bhardwajRahul/autonomous-computer/README.md

# Time to build your own Personal AI Computer

https://github.com/user-attachments/assets/36f7aa02-42ac-4b35-b757-a5dd3b43ef1a

## The future of AI is local

AI in 2026 looks like computing in 1975: the intelligence lives in a few mainframes, owned by a few companies, and you rent it by the token. Everyone knows how that movie ends. The machine moves onto the desk — and the people who own their machines build everything that comes next.

The Personal AI Computer is that machine. The models are good, the GPUs are affordable, and homes and businesses are reaching the same answer: bring it in-house. Three reasons:

1. **No one can switch you off.** In June 2026 the US government took Fable 5 offline for most of a month and gated GPT-5.6 behind an approved-partner list. Weights on your own disk can't be revoked.
2. **Your business is their training data.** Every prompt you send OpenAI or Anthropic carries your product, your process, your edge. They will turn your secret sauce into their product.
3. **Inference becomes free.** Open weights on a cloud API already cut the bill 20–30×. On your own machine there is no bill at all. No API, no meter.

## The end-to-end open-source local AI stack

Open software lets you run and shape your AI; open hardware lets you build, repair, and improve the machine it runs on. With both in your hands — the code, the CAD, the BOM, the BIOS settings — you can build the whole thing end to end. So we open-source both:

- **Open Source Hardware — this repo.** Your Personal AI Computer in four sizes, below: every part, every bracket, every BIOS setting, every assembly photo.
- **Open Source Software — your choice.** The easiest way is [Grid](https://github.com/autonomous-ai/autonomous-grid), the open orchestrator for local AI — but any local AI engine works: vLLM, Ollama, llama.cpp.

## 2× NVIDIA RTX 5090

The entry-level build, for personal use. Enough for Llama, Qwen, and DeepSeek with quantization — run OpenClaw, Hermes Agent, or your own LangChain stack locally.

- **2× NVIDIA RTX 5090** — 64 GB VRAM · 3,584 GB/s · 419 FP32 TFLOPS
- **Intel Xeon W5** (ASUS W790 ACE) · 96 GB RAM · 1 TB NVMe
- **PCIe Gen 5 ×16** per GPU · 10 GbE + 2.5 GbE
- **1,550 W draw** · 1,600 W PSU
- **12.5″ × 12.5″ × 16″** · 33 lb

**[Build the 2× 5090 →](2x-5090/README.md)**

<a href="2x-5090/README.md">The 2× 5090 build — two RTX 5090s on the open frame</a>

<table>
<tr>
<td width="50%">Seating the PCIe riser</td>
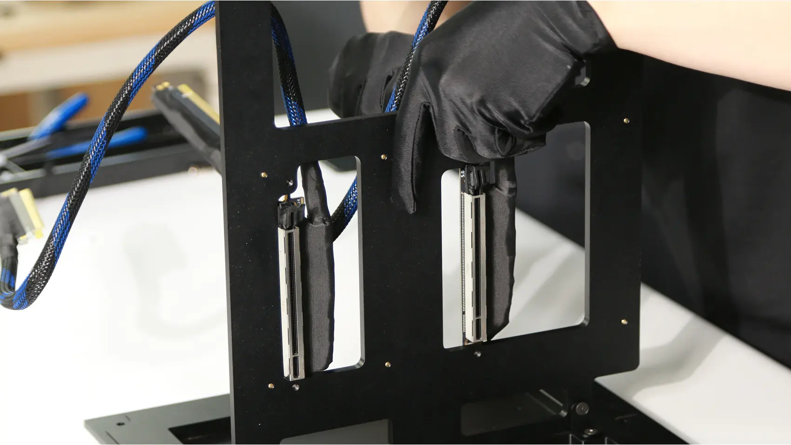
[picture p1: 2x/photos/gallery/riser-frame.webp]
Mounting the PCIe 5.0 risers
<td width="50%"></td>
</tr>
<tr>
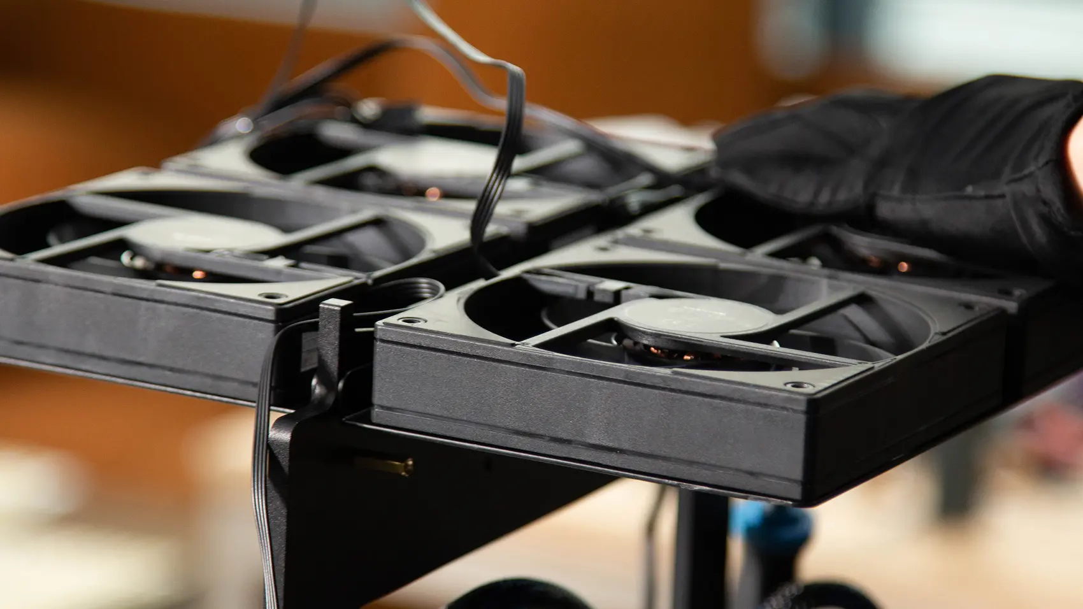
[picture p2: 2x/photos/gallery/fan-tray.webp]
The fan tray
<td width="50%"></td>
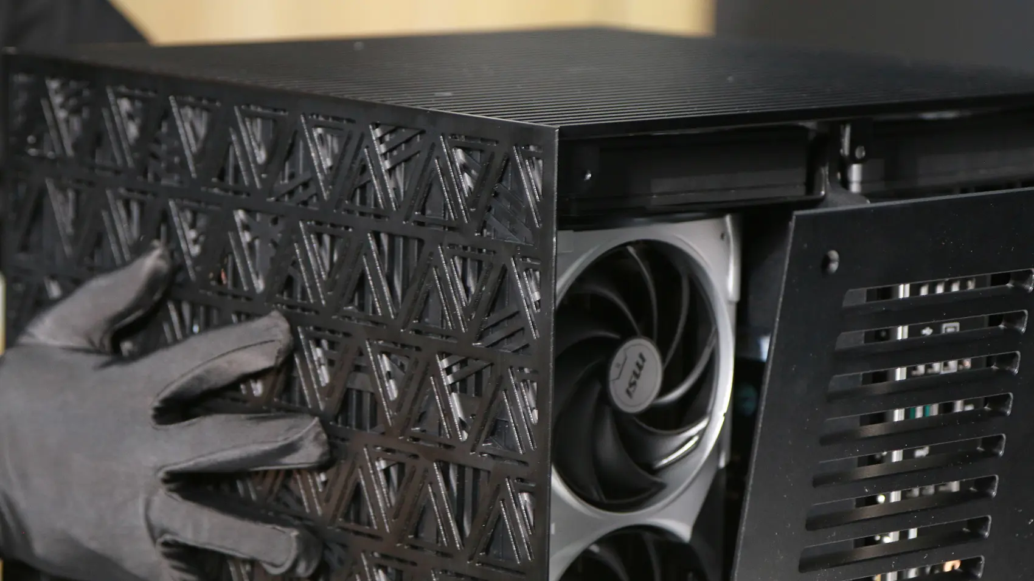
[picture p3: 2x/photos/gallery/side-panel.webp]
Closing the side panel
<td width="50%"></td>
</tr>
</table>

The finished 2× 5090

## 4× NVIDIA RTX 5090

The team build. Larger open models like Kimi, MiniMax, and GLM. No API bills. Low latency. Private data.

- **4× NVIDIA RTX 5090** — 128 GB VRAM · 7,168 GB/s · 838 FP32 TFLOPS
- **AMD Ryzen Threadripper Pro** · 96 GB RAM · 1 TB NVMe
- **PCIe Gen 5 ×16** per GPU · 2× 10 GbE · BMC
- **2,750 W draw** · 4,000 W PSU
- **12.5″ × 12.5″ × 16″** · 66 lb

**[Build the 4× 5090 →](4x-5090/README.md)**

<a href="4x-5090/README.md">The 4× 5090 build — four RTX 5090s in the cube housing</a>

<table>
<tr>
<td width="50%">Motherboard on the fan chassis</td>
<td width="50%">Cabling the power supplies</td>
</tr>
<tr>
<td width="50%">Mounting a GPU to the frame</td>
<td width="50%">All four RTX 5090s on the frame</td>
</tr>
</table>

The finished 4× 5090

## 8× NVIDIA RTX 5090

The on-prem build, for business. Develop, serve, and fine-tune with open models — the work that should never leave your floor.

- **8× NVIDIA RTX 5090** — 256 GB VRAM · 14,336 GB/s · 1,676 FP32 TFLOPS
- **2× AMD EPYC 9004** (ASRock Rack GENOA2D24G-2L+) · 192 GB RAM · 1 TB NVMe
- **PCIe Gen 5 ×16** per GPU, over MCIO · 2× 1 GbE · BMC
- **5,100 W draw** · 8,000 W PSU
- **15.5″ × 15.5″ × 24″** · 110 lb · CNC-milled anodized aluminum housing

**[Build the 8× 5090 →](8x-5090/README.md)**

<a href="8x-5090/README.md">The 8× 5090 build — eight GPUs in the anodized aluminum housing</a>

<table>
<tr>
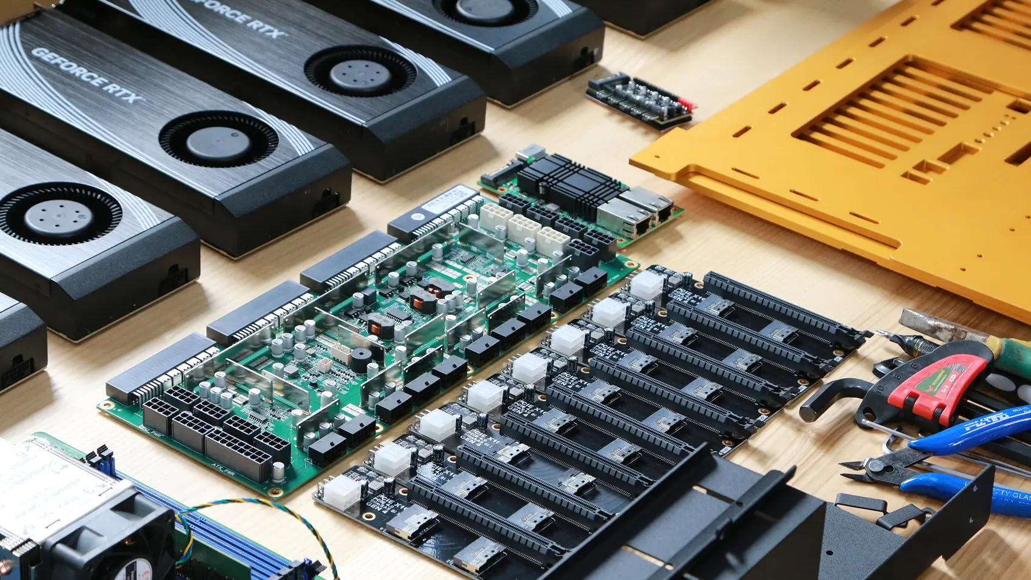
[picture p4: 8x/photos/gallery/parts-layout.webp]
Every part laid out before assembly
<td width="50%"></td>
<td width="50%">Placing an MCIO adapter</td>
</tr>
<tr>
<td width="50%">Cabling the PCIe adapters</td>
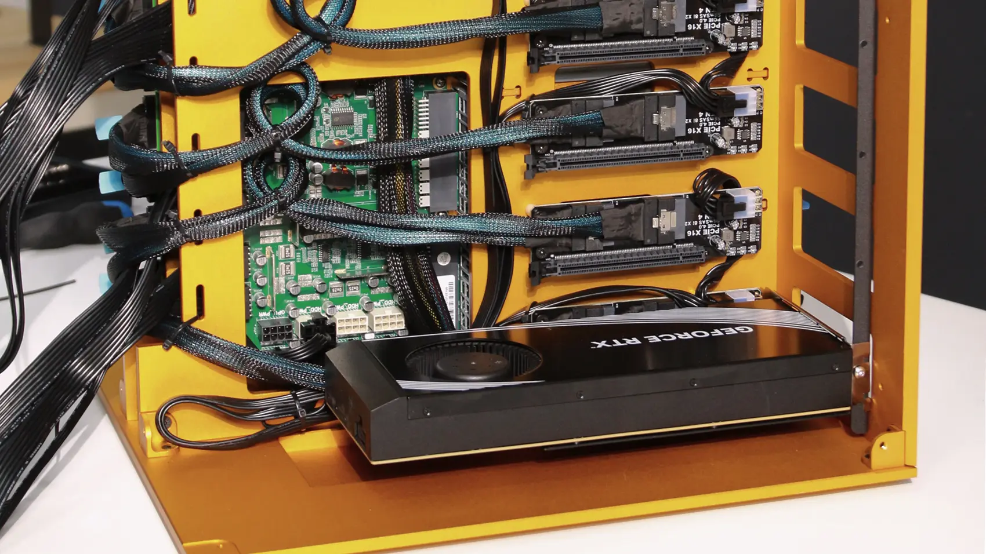
[picture p5: 8x/photos/gallery/gpu-install.webp]
Installing the GPUs
<td width="50%"></td>
</tr>
</table>

The finished 8× 5090

## 4× NVIDIA RTX PRO 6000

The server build — rack-ready for on-prem and the data center. 384 GB of VRAM: fine-tune and serve the biggest open models.

- **4× NVIDIA RTX PRO 6000 Blackwell** — 384 GB GDDR7 ECC · 7,168 GB/s (96 GB per card)
- **AMD EPYC 9124** (ASRock Rack TURIN2D24G-2L+) · 384 GB DDR5 ECC · 1 TB NVMe
- **PCIe Gen 5 ×16** per GPU, over MCIO · BMC
- **3× 2,000 W** CRPS
- **5U rack chassis**

**[Build the 4× 6000 →](4x-6000/README.md)**

<a href="4x-6000/README.md">The 4× 6000 build racked — 5U chassis in the server rack</a>

<table>
<tr>
<td width="50%">Installing the RTX PRO 6000s</td>
<td width="50%">Four flow-through RTX PRO 6000s over the airflow modules</td>
</tr>
<tr>
<td width="50%">Full chassis interior — GPUs, fan wall, dual-SP5 board</td>
<td width="50%">MCIO riser boards before the GPUs go in</td>
</tr>
</table>

GPU power cabling detail

## Software

1. **[BIOS tuning and GPU testing](setup.md)** — after you build the rig, run this to make sure it actually works: BIOS settings for multi-GPU, NVIDIA drivers, then confirm every GPU is detected, linked at full PCIe width, and stable under load.

gpu-testing

2. **Serve your models** — the rig runs, now put it to work. The easiest way is [Grid](https://github.com/autonomous-ai/autonomous-grid), the open orchestrator for local AI: it pools your machines into one local AI network. Or run any local AI engine — vLLM, Ollama, llama.cpp.

   ```bash
   curl -fsSL https://grid.autonomous.ai/install.sh | bash
   ```

home-grid (1)

## Contributing

Built one? Improved a part? Found a better component? See [**CONTRIBUTING.md**](CONTRIBUTING.md) — and [share your build](https://github.com/autonomous-ai/autonomous-computer/issues/new?template=share-your-build.md). The best community builds get featured.

## License

Open source under the [MIT License](LICENSE). Fork it, change it, build your own and sell it — we just want it built.

---

<div align="center">
<b>Autonomous</b> — the AI hardware company.<br>
Questions? <a href="https://github.com/autonomous-ai/autonomous-computer/issues">Open an issue.</a>
</div>
