bhardwajRahul/autonomous-computer/Docs/Prepare_EE.md

<table>
    <tr>
        <td valign="top" align="center" width="50%">
            <b>1. Motherboard GENOA2D24G-2L+</b><br>
            <br>
            <b>3. CPU AMD EPYC 9004</b><br>
            <br>
            <b>5. SSD NVME 1TB</b><br>
            <br>
            <b>7. RAM DDR5 48GB</b><br>
            <br>
            <b>9. MCIO Adapter</b><br>
            <br>
            <b>11. MCIO cable</b><br>
            <br>
            <b>13. Fan</b><br>
            <br>
            <b>15. Motherboard power cable</b><br>
            <br>
        </td>
        <td valign="top" align="center" width="50%">
            <b>2. PSU board</b><br>
            <br>
            <b>4. CPU heat sink</b><br>
            <br>
            <b>6. SSD heat sink</b><br>
            <br>
            <b>8. PSU</b><br>
            <br>
            <b>10. Power cord</b><br>
            <br>
            <b>12. GPU</b><br>
            <br>
            <b>14. Hub fan</b><br>
            <br>
            <b>16. GPU power cable</b><br>
            <br>
        </td>
    </tr>
</table>

---
