bhardwajRahul/autonomous-computer/4x-5090/docs/prepare-ee.md

# Preparation — Electronic & Electrical

Every part in the [bill of materials](../bom/bom.md), photographed. Lay them all out before you start assembly.

> **Mostly representative product images — pending photos of the actual build** (the GPUs, item 6, are from this build). Exact models are being confirmed; see the BOM for the parts marked TBD.

<table>
    <tr>
        <td valign="top" align="center" width="50%">
            <b>1. Mainboard — AMD WRX90 (model TBD)</b><br>
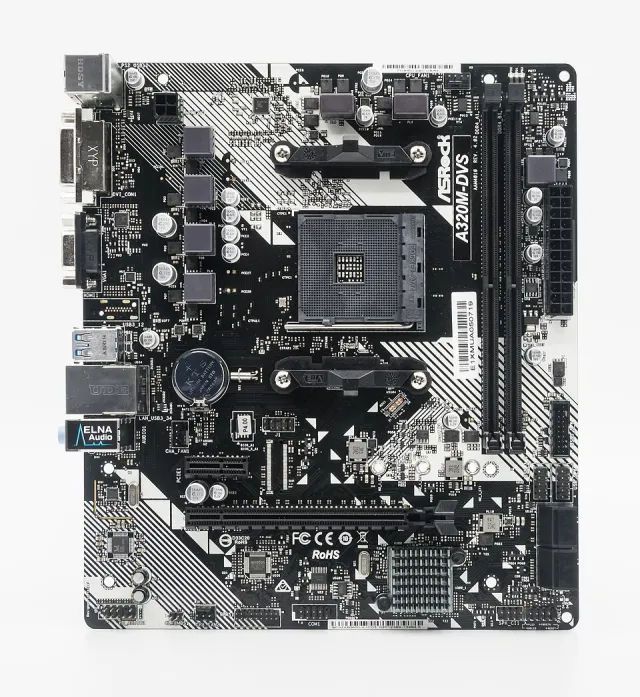
[picture p18: 4x-5090/photos/4gpu/preparing/ee/motherboard.webp]
            <br>
            <b>3. CPU heatsink — sTR5 cooler</b><br>
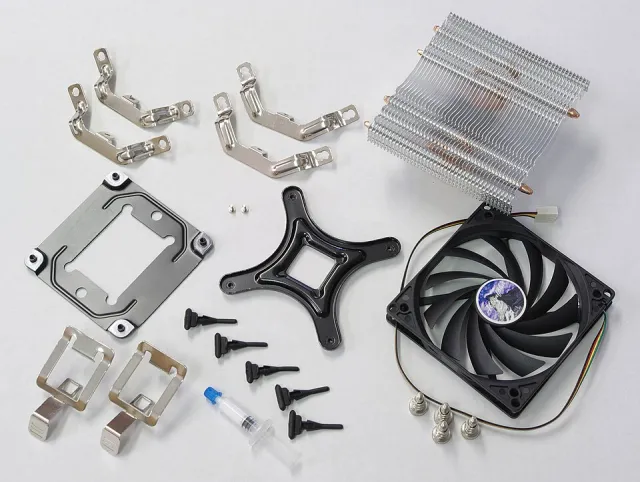
[picture p19: 4x-5090/photos/4gpu/preparing/ee/cpu-heatsink.webp]
            <br>
            <b>5. SSD — 1 TB NVMe</b><br>
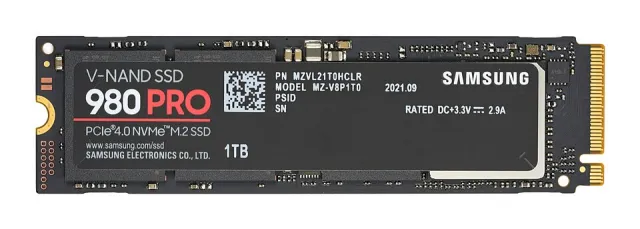
[picture p20: 4x-5090/photos/4gpu/preparing/ee/ssd.webp]
            <br>
            <b>7. PCIe 5.0 riser cable (×4)</b><br>
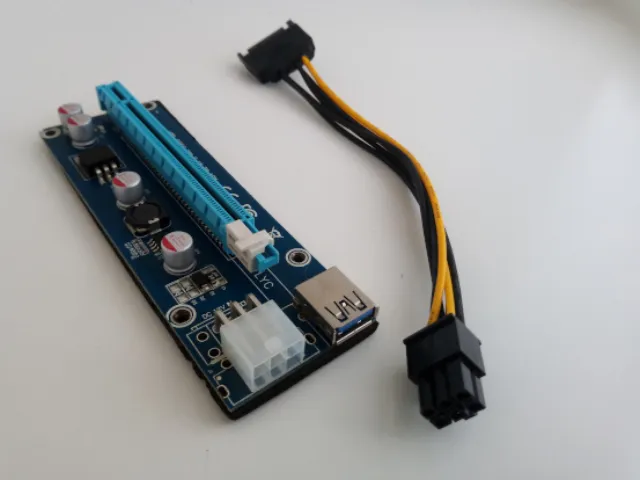
[picture p21: 4x-5090/photos/4gpu/preparing/ee/riser.webp]
            <br>
            <b>9. GPU power cable — 12VHPWR (×4)</b><br>
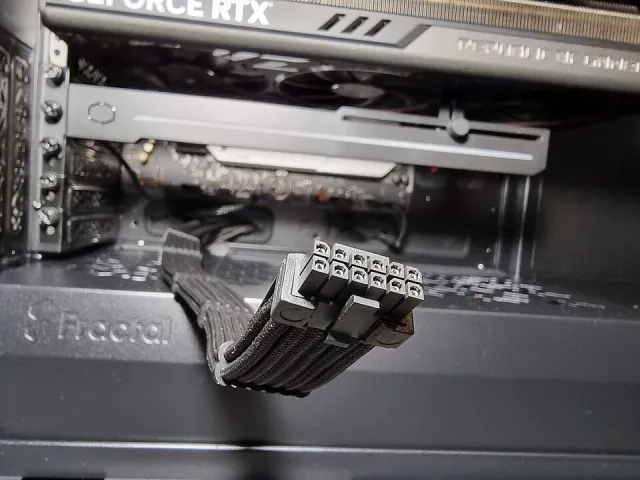
[picture p22: 4x-5090/photos/4gpu/preparing/ee/gpu-power-cable.webp]
            <br>
            <b>11. Fan (×4)</b><br>
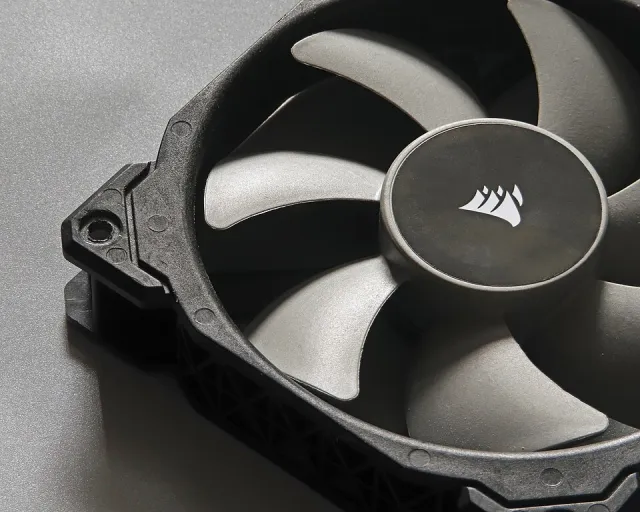
[picture p23: 4x-5090/photos/4gpu/preparing/ee/fan.webp]
            <br>
        </td>
        <td valign="top" align="center" width="50%">
            <b>2. CPU — AMD Ryzen Threadripper PRO</b><br>
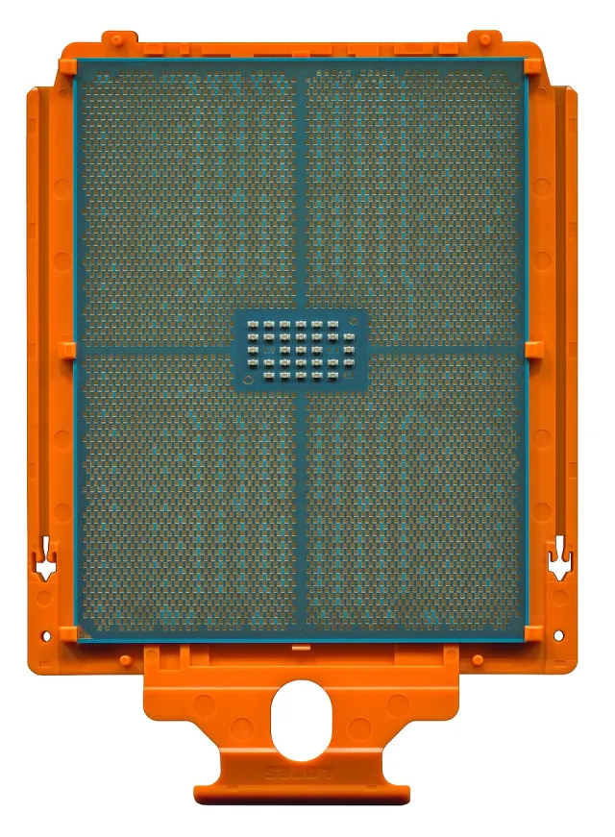
[picture p24: 4x-5090/photos/4gpu/preparing/ee/cpu.webp]
            <br>
            <b>4. RAM — DDR5 96 GB</b><br>
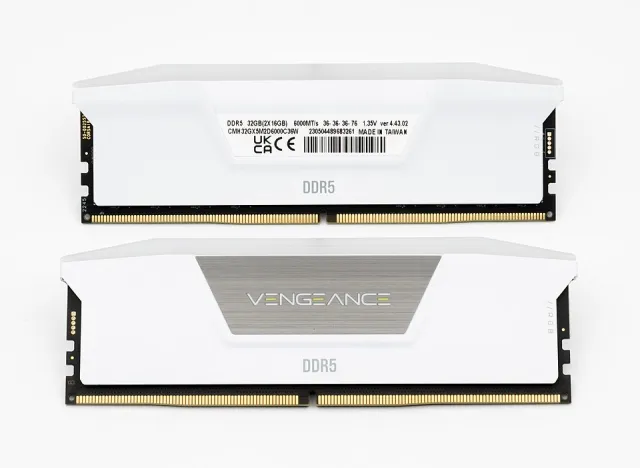
[picture p25: 4x-5090/photos/4gpu/preparing/ee/ram.webp]
            <br>
            <b>6. GPU — MSI GeForce RTX 5090 (×4)</b><br>
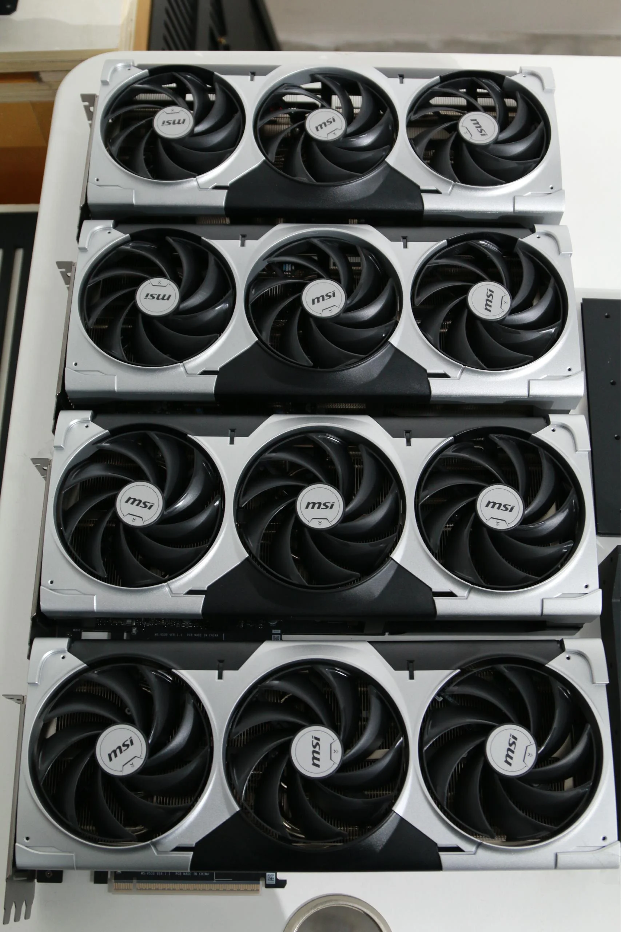
[picture p26: 4x-5090/photos/gallery/gpu-cards.webp]
            <br>
            <b>8. PSU — 4000 W</b><br>
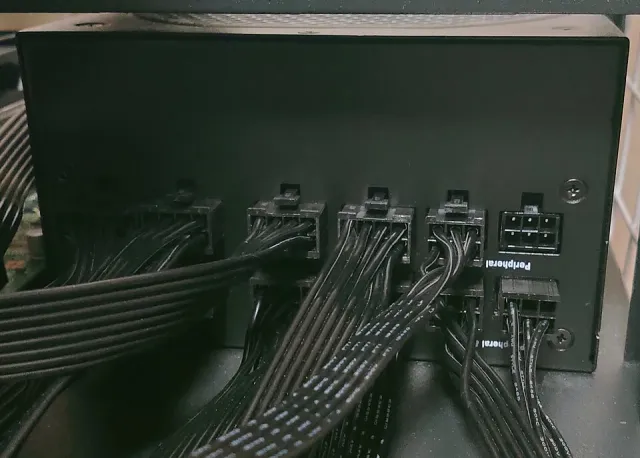
[picture p27: 4x-5090/photos/4gpu/preparing/ee/psu.webp]
            <br>
            <b>10. Power cord</b><br>
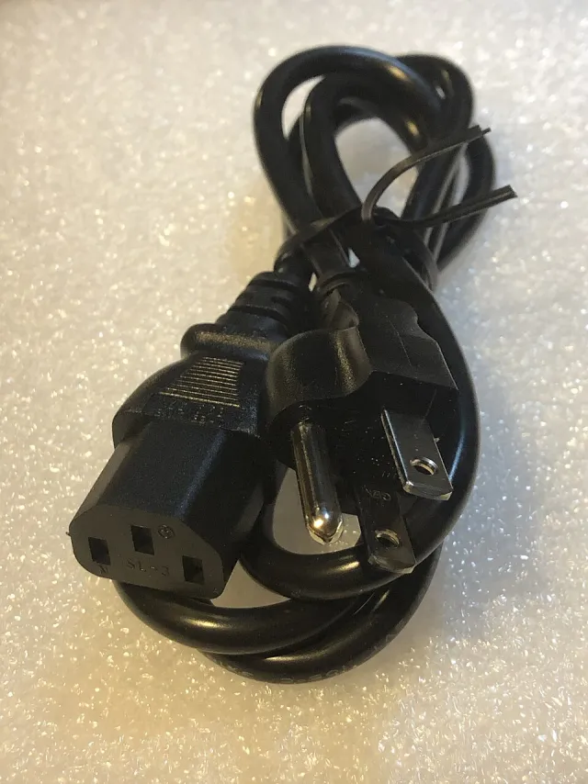
[picture p28: 4x-5090/photos/4gpu/preparing/ee/power-cord.webp]
            <br>
        </td>
    </tr>
</table>

Next: [assembly](assembly.md).
