bhardwajRahul/autonomous-computer/4x-6000/docs/prepare-ee.md

# Preparation — Electronic & Electrical

The electronic and electrical components for one 5U server. Lay them out and check them off before assembly.

| No  | Component | Detail | Qty |
|:---:|:---|:---|:---:|
|  1  | Motherboard ASRock Rack TURIN2D24G-2L+ | 500W power input, dual SP5 |  1  |
|  2  | CPU AMD EPYC 9124 | SP5 socket, Zen4 Genoa, 16C/32T, 200W TDP |  1  |
|  3  | CPU Heatsink | COOLSERVER 2U SP5 S22, 6 heat pipes, 380W PWM |  1  |
|  4  | RAM DDR5 ECC RDIMM | 48 GB module @ 5600 MT/s — 384 GB total |  8  |
|  5  | SSD | Samsung 990 EVO Plus 1TB NVMe |  1  |
|  6  | GPU | NVIDIA RTX PRO 6000 Blackwell Workstation Edition |  4  |
|  7  | PSU | Changcheng (Great Wall) 2000W CRPS |  3  |
|  8  | 5U chassis kit | Includes case, internal cables, and power board |  1  |

---
