bhardwajRahul/autonomous-computer/2x-rtx5090/photos/2gpu/preparing/ee/hub_fan.jpg

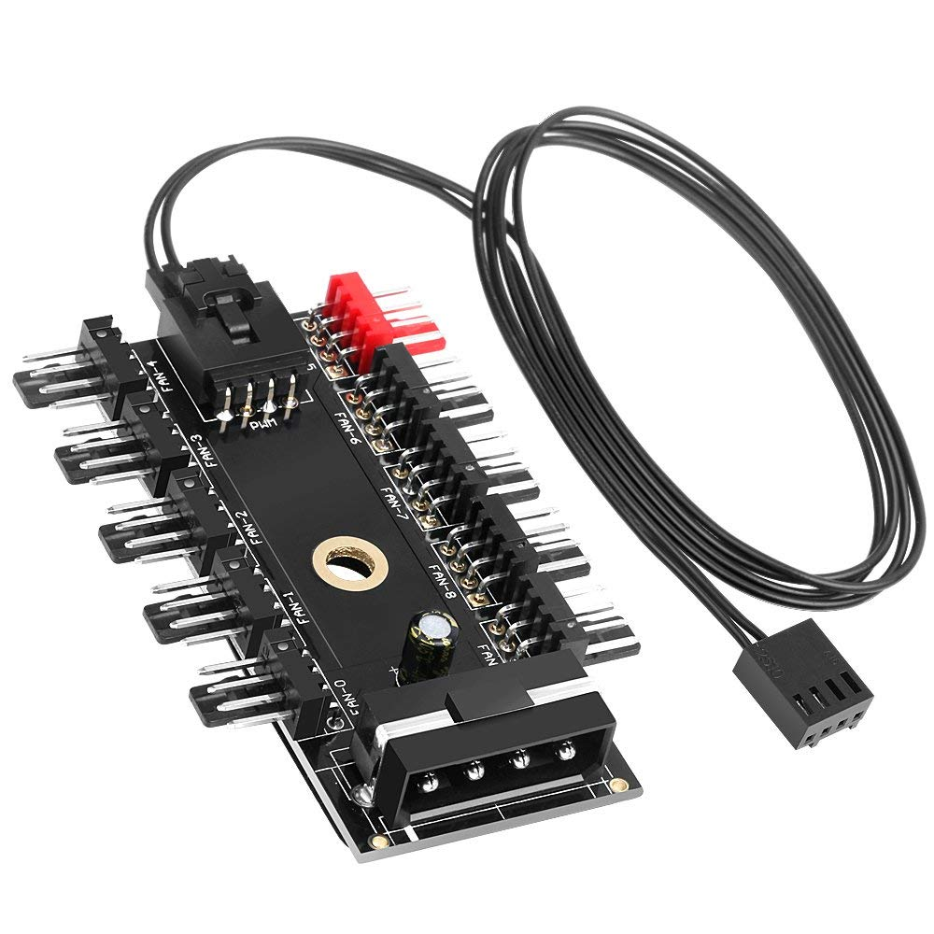
2x-rtx5090/photos/2gpu/preparing/ee/hub_fan.jpg
