bhardwajRahul/autonomous-computer/2x-rtx5090/photos/2gpu/preparing/ee/power_cord.jpg

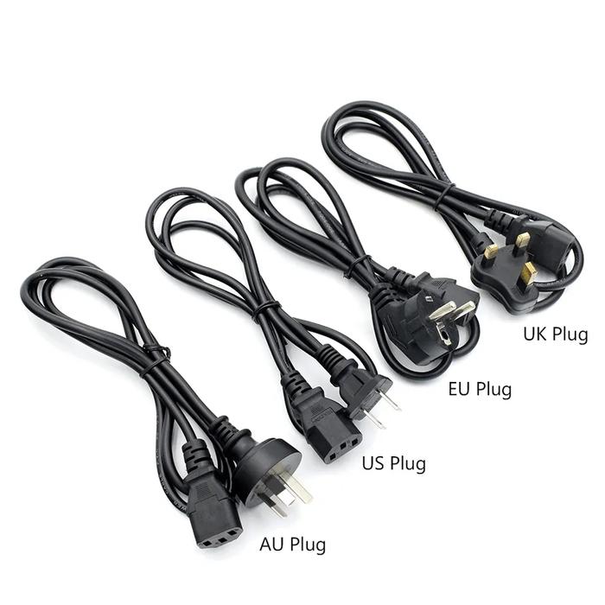
2x-rtx5090/photos/2gpu/preparing/ee/power_cord.jpg
