bhardwajRahul/autonomous-computer/2x/photos/gallery/finished.webp

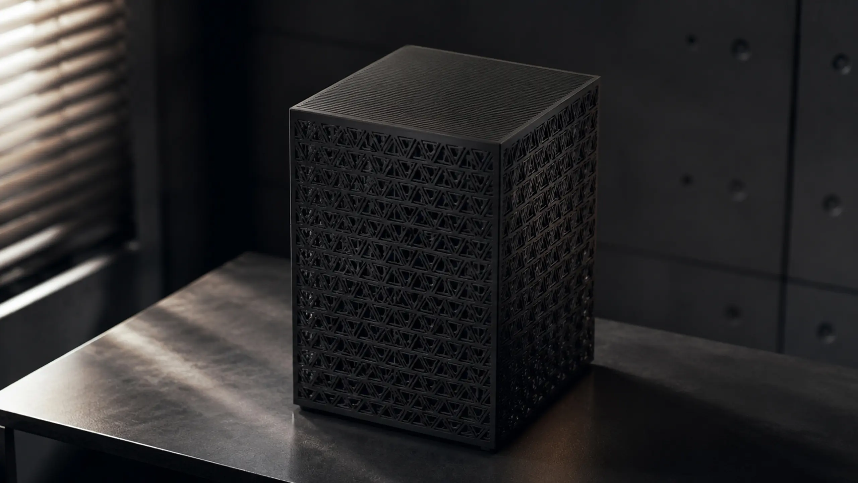
2x/photos/gallery/finished.webp
