bhardwajRahul/autonomous-computer/2x/photos/gallery/hero.webp

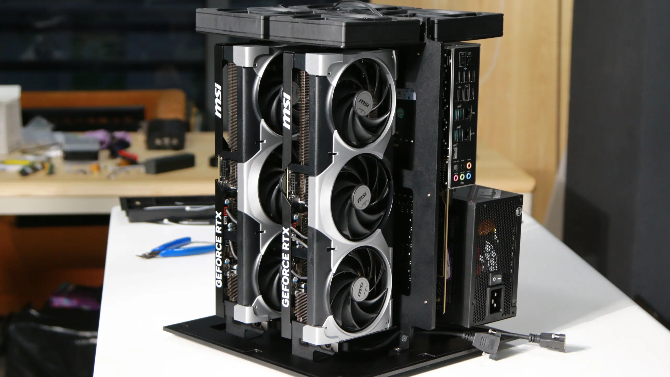
2x/photos/gallery/hero.webp
