bhardwajRahul/autonomous-computer/8x/photos/gallery/cnc-milling.webp

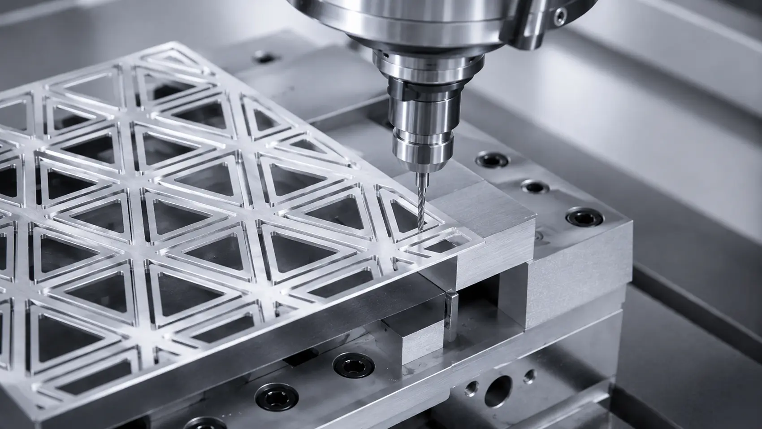
8x/photos/gallery/cnc-milling.webp
