bhardwajRahul/autonomous-computer/8x/photos/gallery/finished.webp

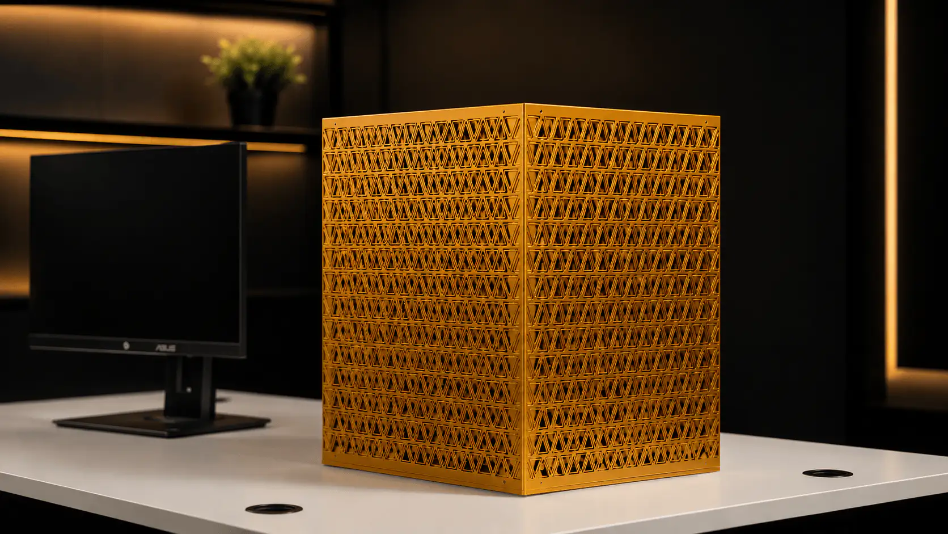
8x/photos/gallery/finished.webp
