bhardwajRahul/autonomous-computer/8x/photos/gallery/hero.webp

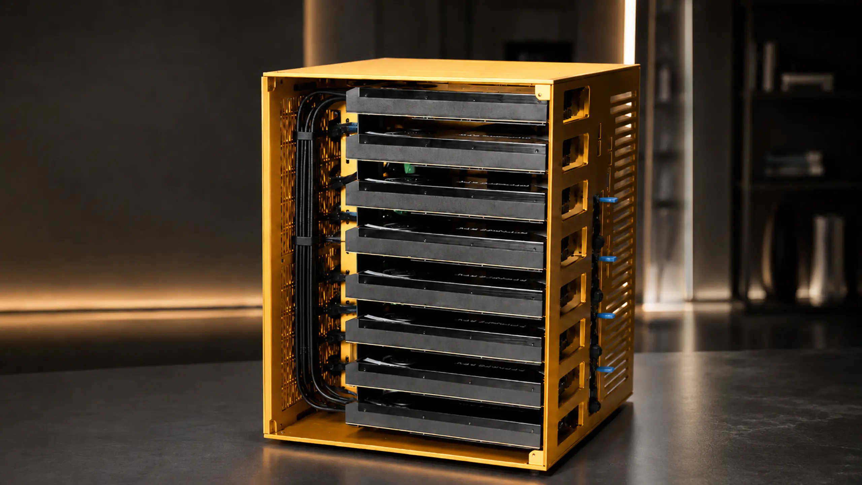
8x/photos/gallery/hero.webp
