bhardwajRahul/autonomous-computer/4x-6000/bom/bom.md

# Bill of Materials

Quantities are **per server** — one 5U chassis with 4× RTX PRO 6000 GPUs.

| No  | Item | Detail | Qty | Category | Source | Notes |
|:---:|:---|:---|:---:|:---|:---|:---|
|  1  | Mainboard | ASRock Rack TURIN2D24G-2L+ / 500W |  1  | Mainboard | [asrockrack.com](https://www.asrockrack.com/general/productdetail.asp?Model=TURIN2D24G-2L+/500W) | Dual SP5; designed for EPYC 9005 (Turin) — confirm 9004 (Genoa) BIOS support for 9124 |
|  2  | CPU | AMD EPYC 9124 |  1  | Processor | [amd.com](https://www.amd.com/en/products/processors/server/epyc/4th-generation-9004-and-8004-series/amd-epyc-9124.html) | 16C/32T Zen4, SP5, 200W (single-socket on a dual-socket board) |
|  3  | CPU Heatsink | COOLSERVER 2U AMD EPYC SP5 S22 — 6 heat pipes, L118 × W92.4 × H66.3 mm, PWM 2600–8000 RPM, 52.50 dB (max), 47.20 CFM, 4-pin PWM, 380 W |  1  | Cooling | [teket alibaba store](https://teket.en.alibaba.com/) | |
|  4  | RAM | DDR5 ECC RDIMM 48 GB @ 5600 MT/s |  8  | Memory | — | 384 GB total |
|  5  | SSD | Samsung 990 EVO Plus 1TB NVMe |  1  | Storage | — | |
|  6  | GPU | NVIDIA RTX PRO 6000 Blackwell Workstation Edition (reference board 900-5G144-2200-000) |  4  | Graphics Card | [nvidia.com](https://www.nvidia.com/en-us/products/workstations/professional-desktop-gpus/rtx-pro-6000/) | |
|  7  | PSU | Changcheng (Great Wall) 2000W CRPS |  3  | Power Supply  | [alibaba](https://www.alibaba.com/product-detail/Hot-Plug-Great-Wall-2000w-Crps_1600846038726.html) | 6000W total |
|  8  | 5U Case | ASRock 5U850 Gen5 chassis (case, cable harness, power board included) — supports up to 8 GPUs, populated with 4 |  1  | Housing | [alibaba](https://www.alibaba.com/product-detail/ASRock-5U850-Gen5-8-GPU-RTX5090_1601578398768.html) | |
