bhardwajRahul/autonomous-computer/2x-rtx5090/bom/BoM.md

| No  | Item | Qty | Category | Photo | Notes |
|:---:|:---:|:-----:|:---:|:---:|:---:|
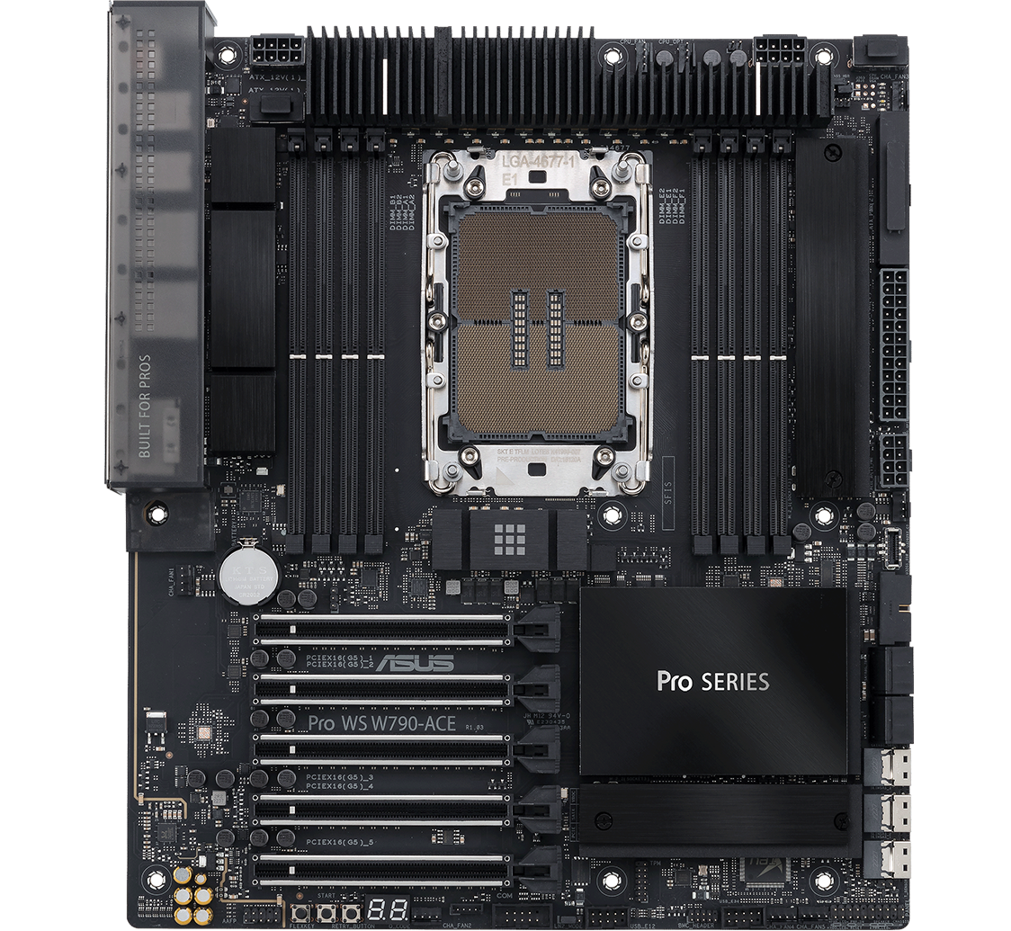
[picture p36: 2x-rtx5090/photos/2gpu/preparing/ee/motherboard_w790.png]
Motherboard
|  1  | ASUS W790 ACE |  1 | Mainboard | | | |  
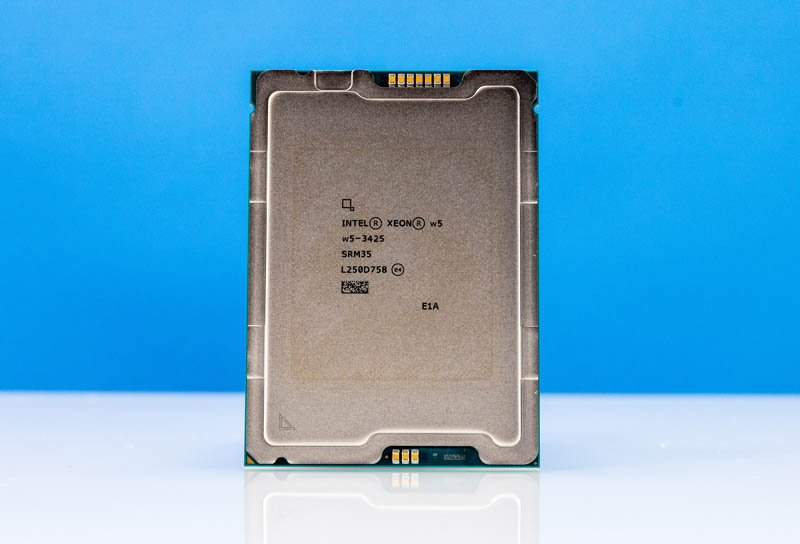
[picture p37: 2x-rtx5090/photos/2gpu/preparing/ee/Intel-Xeon-w5.jpg]
CPU
|  2  | Intel Xeon W5 |  1 | Processor |  | LGA 4677 socket |
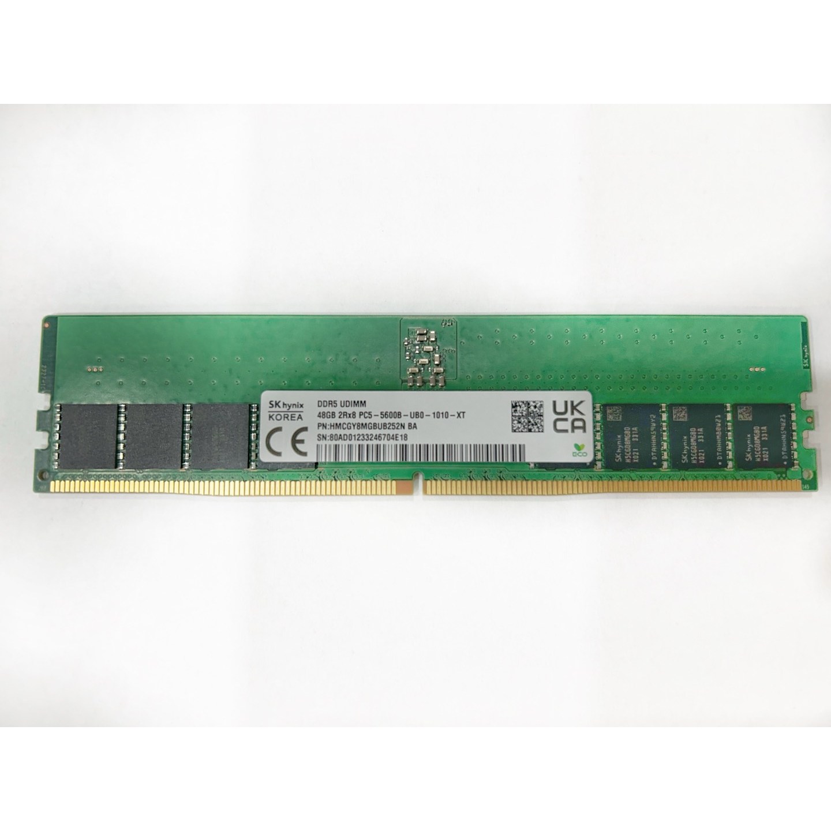
[picture p38: 2x-rtx5090/photos/2gpu/preparing/ee/RAM_DDR5.jpg]
RAM
|  3  | RAM DDR5 |  4 | Memory |  | Configurable (1–8) |
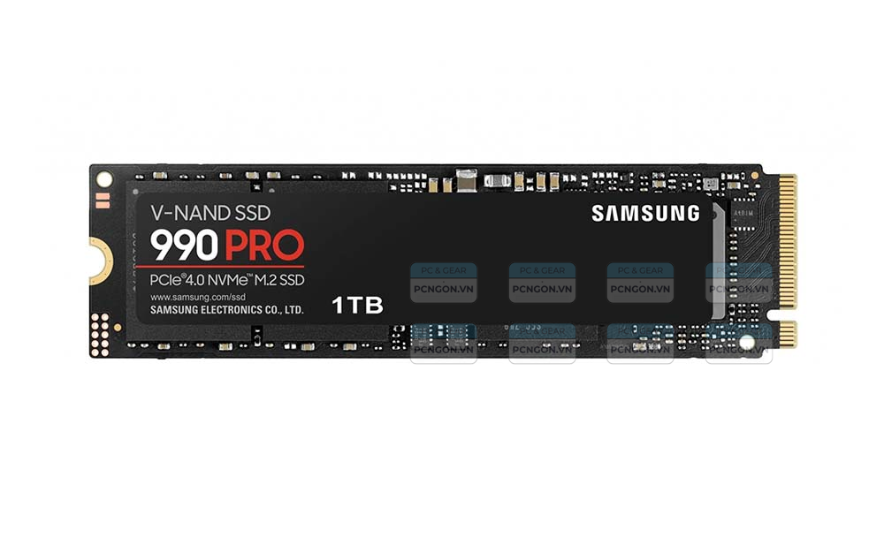
[picture p39: 2x-rtx5090/photos/2gpu/preparing/ee/SSD.png]
SSD
|  4  | SSD (1TB) |  1 | Storage |  | 1TB (configurable) |
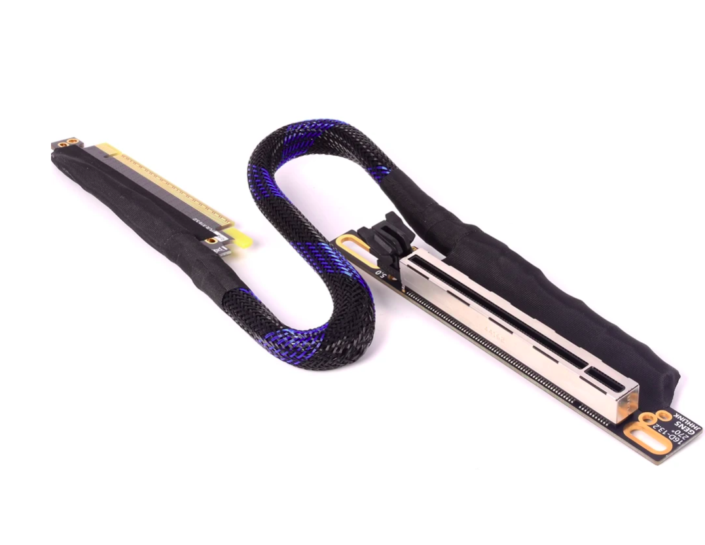
[picture p40: 2x-rtx5090/photos/2gpu/preparing/ee/PCIE5_riser_cable.png]
PCIe 5 Riser
|  5  | PCIe 5 Riser Cable |  2 | Cable |  | |
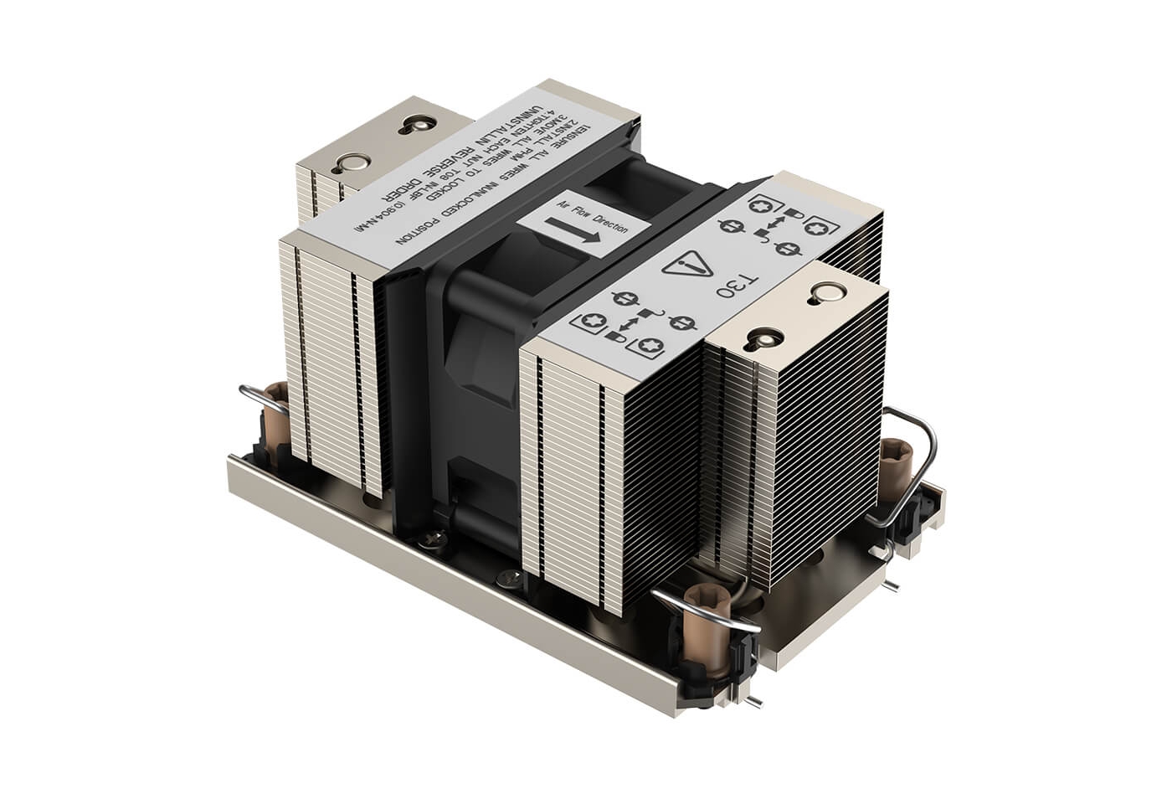
[picture p41: 2x-rtx5090/photos/2gpu/preparing/ee/cpu-heatsink.jpg]
CPU Heatsink
|  7  | CPU Heatsink |  1 | Cooling |  | |
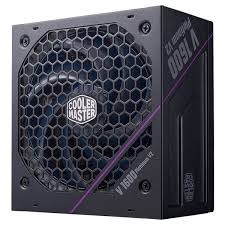
[picture p42: 2x-rtx5090/photos/2gpu/preparing/ee/psu.jpg]
PSU
|  9  | Power Supply Units (PSU)  |  1 | Power Supply |  | 1600W |
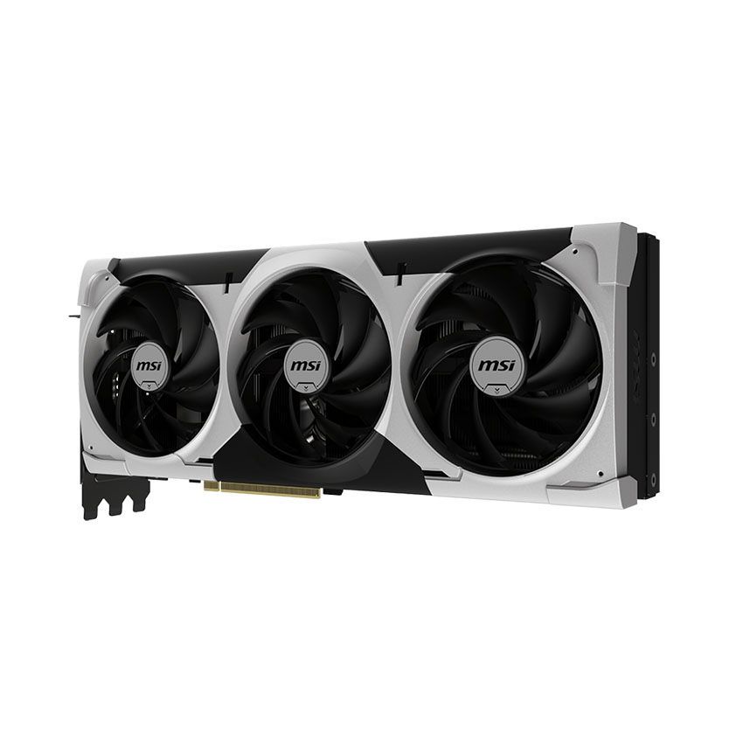
[picture p43: 2x-rtx5090/photos/2gpu/preparing/ee/GPU.jpg]
GPU
| 11  | GPUs |  2 | Graphics Card |  | |
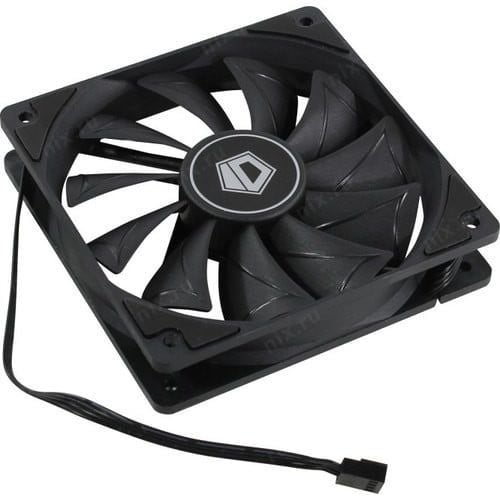
[picture p44: 2x-rtx5090/photos/2gpu/preparing/ee/fan.jpg]
Fan
| 13  | Fan |  4 | Cooling |  | |
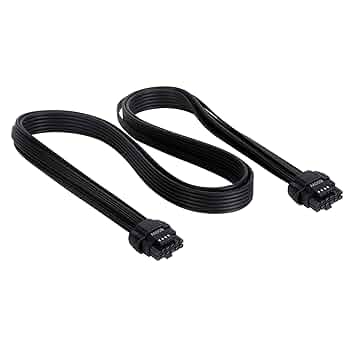
[picture p45: 2x-rtx5090/photos/2gpu/preparing/ee/GPU_cable_power.jpg]
GPU Power Cable
| 15  | GPU Power Cable (600W) |  2 | Cable |  | 600W option |
| 16  | Frame housing |  1 | housing |- | 1 set (full) |
