bhardwajRahul/autonomous-computer/2x-rtx5090/step_models/GPU mount 2.step

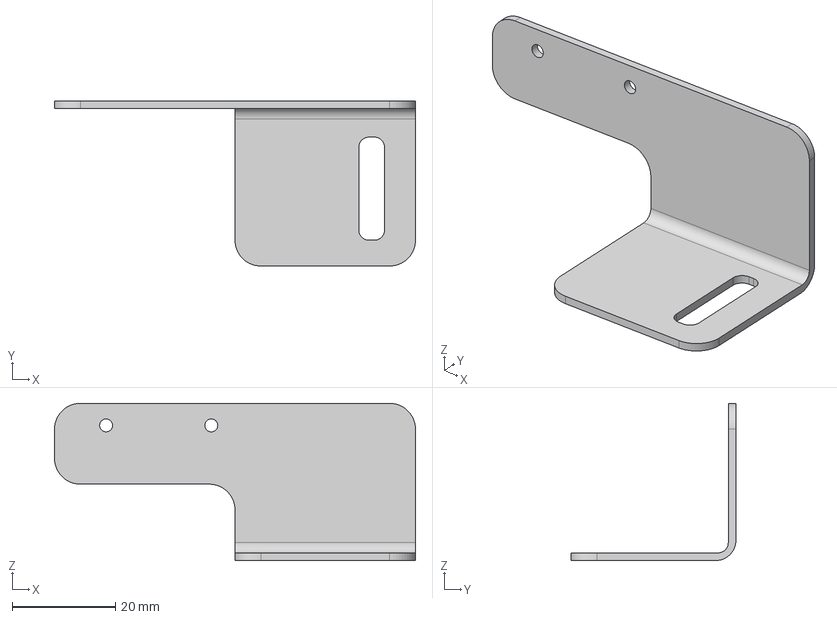
[picture p46: CAD file, 2026-06-01]
2x-rtx5090/step_models/GPU mount 2.step
70.0 x 32.0 x 30.5 mm
