bhardwajRahul/autonomous-computer/2x-rtx5090/stl-models/Part 2 - Back.stl

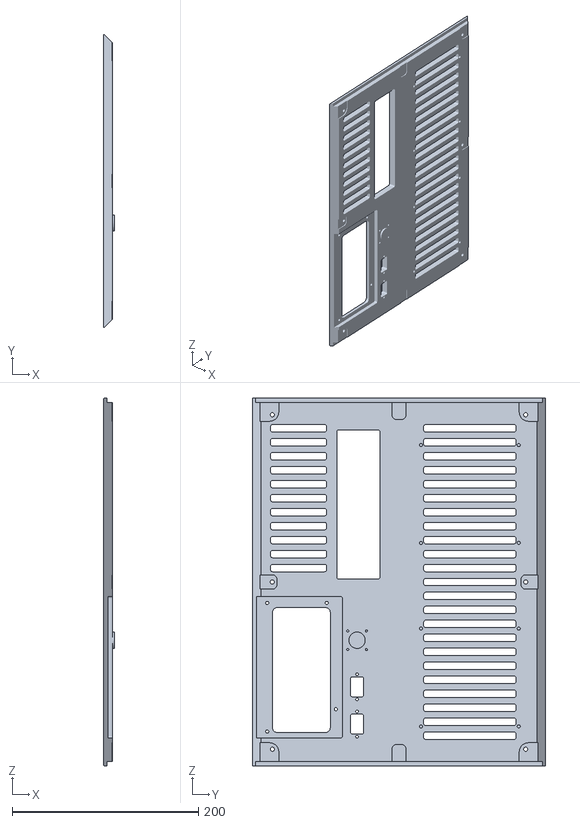
[picture p47: CAD file, 2026-06-01]
2x-rtx5090/stl-models/Part 2 - Back.stl
12.0 x 315.0 x 395.0
