bhardwajRahul/autonomous-computer/2x-rtx5090/step_models/Support.step

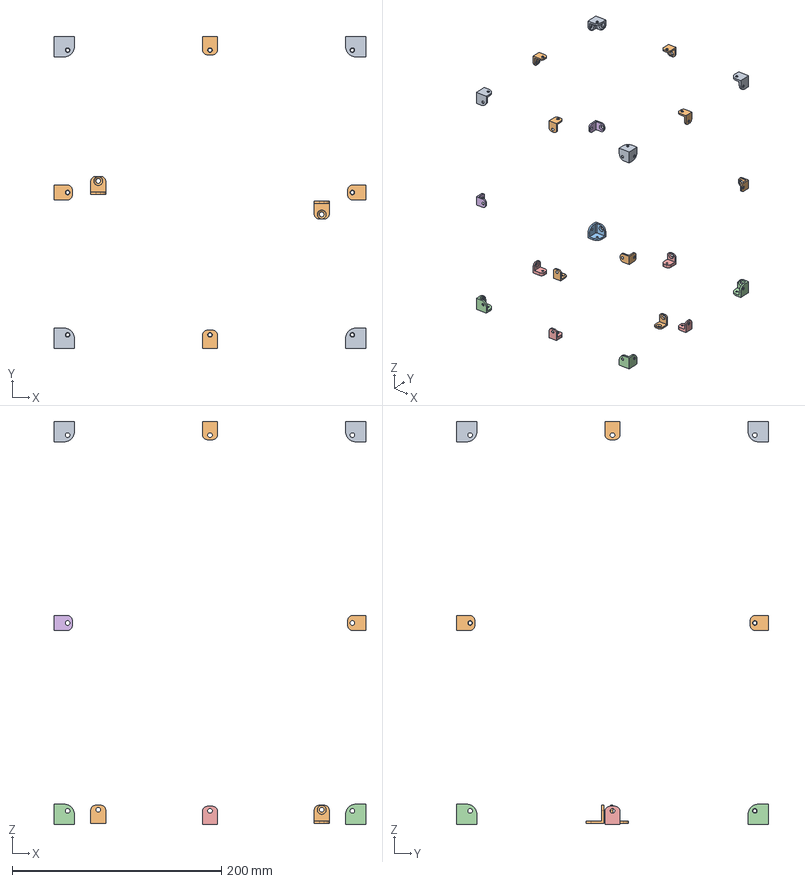
[picture p48: CAD file, 2026-06-01]
2x-rtx5090/step_models/Support.step
298.0 x 298.0 x 385.0 mm
