bhardwajRahul/autonomous-computer/2x-rtx5090/stl-models/Part 6 - Side cover.stl

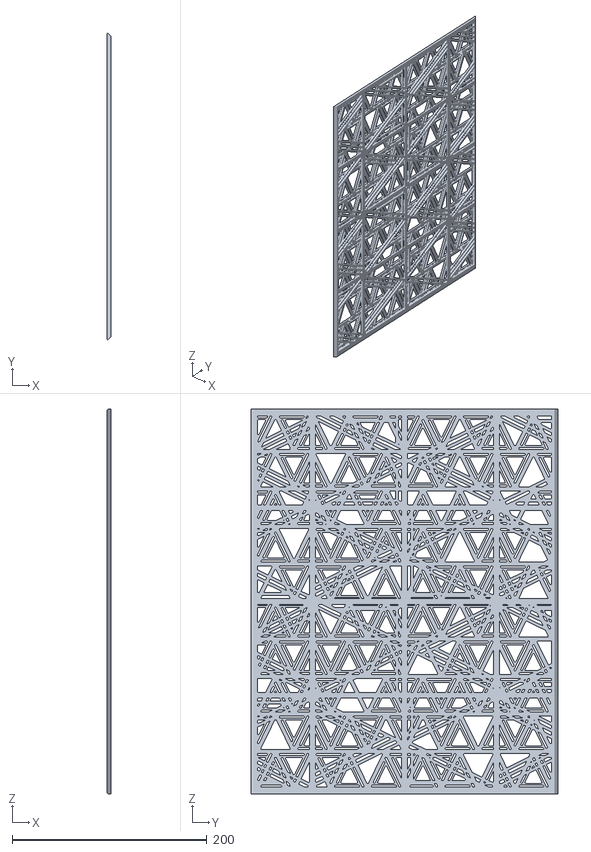
[picture p49: CAD file, 2026-06-01]
2x-rtx5090/stl-models/Part 6 - Side cover.stl
4.00 x 315.0 x 395.0
