bhardwajRahul/autonomous-computer/2x-rtx5090/step_models/Part 1 - Side.step

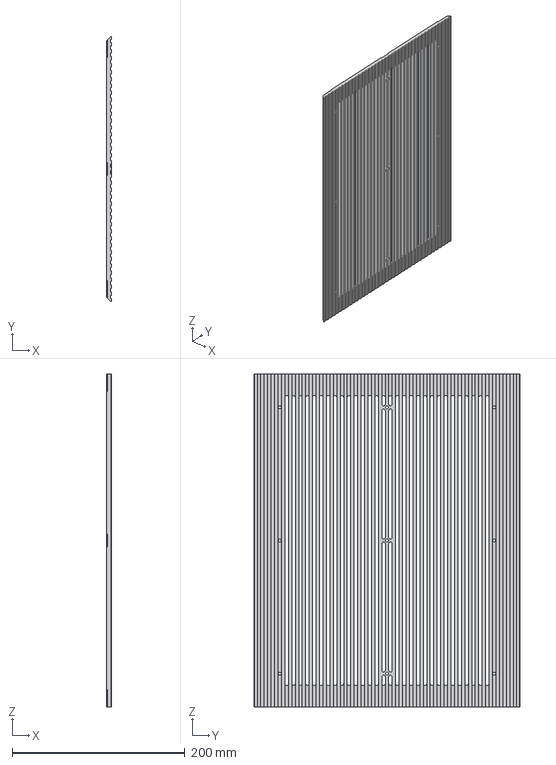
[picture p50: CAD file, 2026-06-01]
2x-rtx5090/step_models/Part 1 - Side.step
6.00 x 307.0 x 385.0 mm
