bhardwajRahul/autonomous-computer/2x-rtx5090/step_models/Part 3 - Top.step

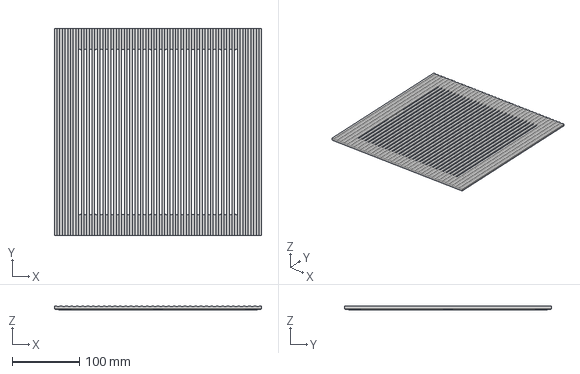
[picture p51: CAD file, 2026-06-01]
2x-rtx5090/step_models/Part 3 - Top.step
307.6 x 307.6 x 6.00 mm
