bhardwajRahul/autonomous-computer/(list of files, cad)

Other CAD files:
2x-rtx5090/stl-models/Part 1 - Side.stl
2x-rtx5090/stl-models/Part 3 - Top.stl
2x-rtx5090/stl-models/Part 4 - Bottom.stl
2x-rtx5090/stl-models/Part 5 - Middle.stl
