bhardwajRahul/autonomous-computer/Docs/Assembly.md

| Step | Description | Image |
|---|---|---|
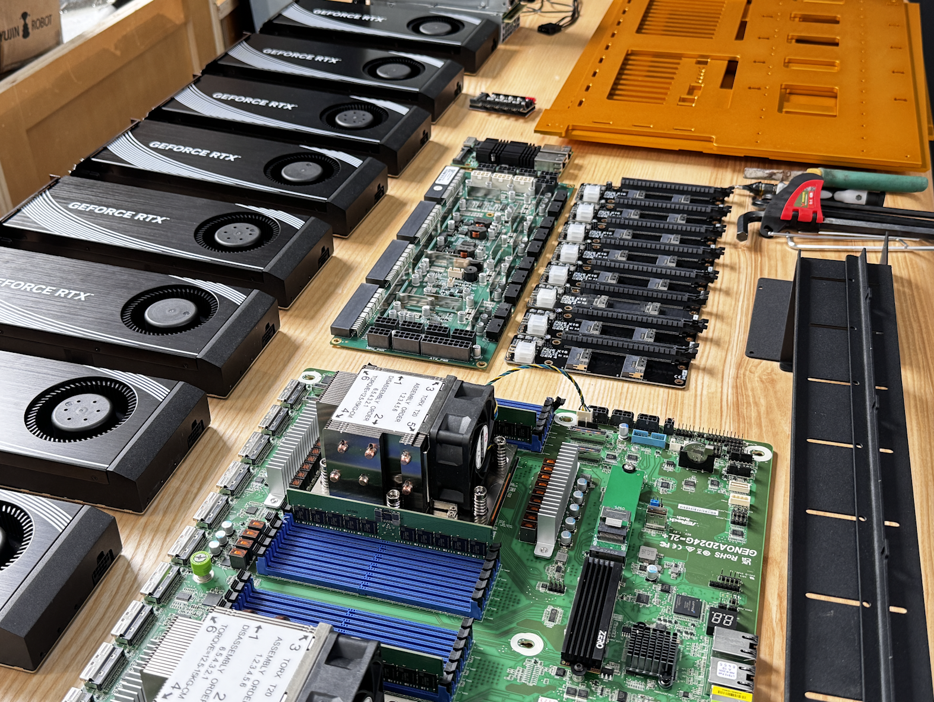
[picture p55: Photos/8GPU/Assembly/1-Preparing all components.png]
| 1 | Prepare all components. |  |
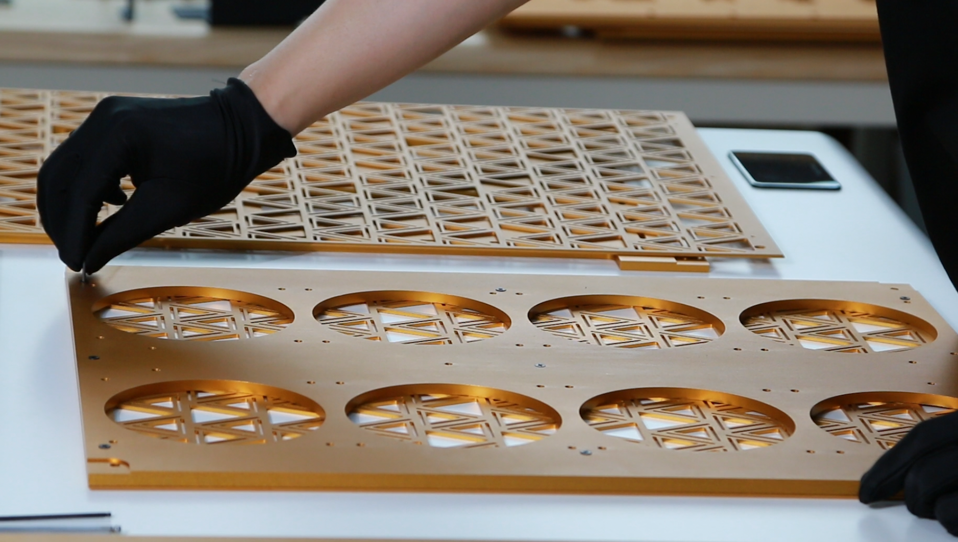
[picture p56: Photos/8GPU/Assembly/2.png]
| 2 | Assemble “Part 7 – Side” and “Part 8 – Side Cover” together. Repeat for the other side. |  |
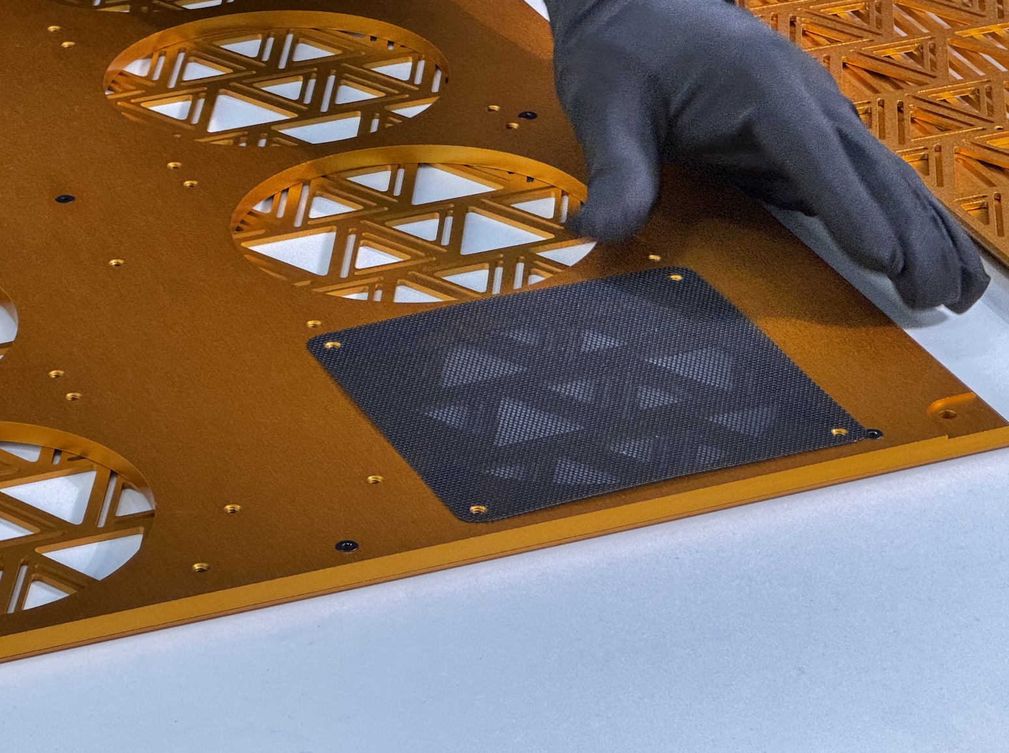
[picture p57: Photos/8GPU/Assembly/3.png]
| 3 | Install the dust filter. |  |
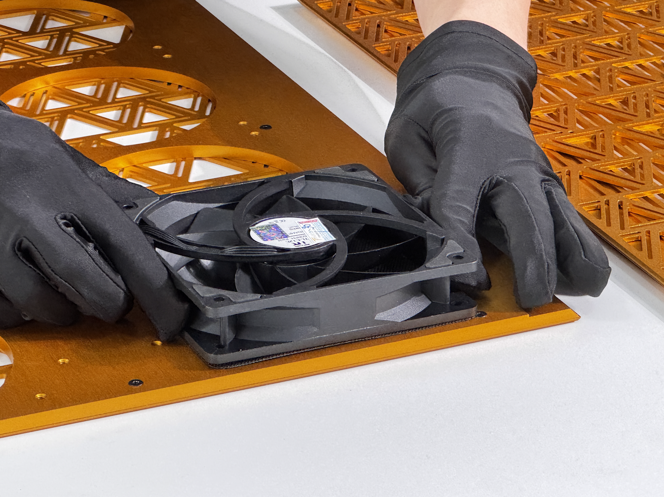
[picture p58: Photos/8GPU/Assembly/4.png]
| 4 | Assemble the 120 mm × 120 mm fan. |  |
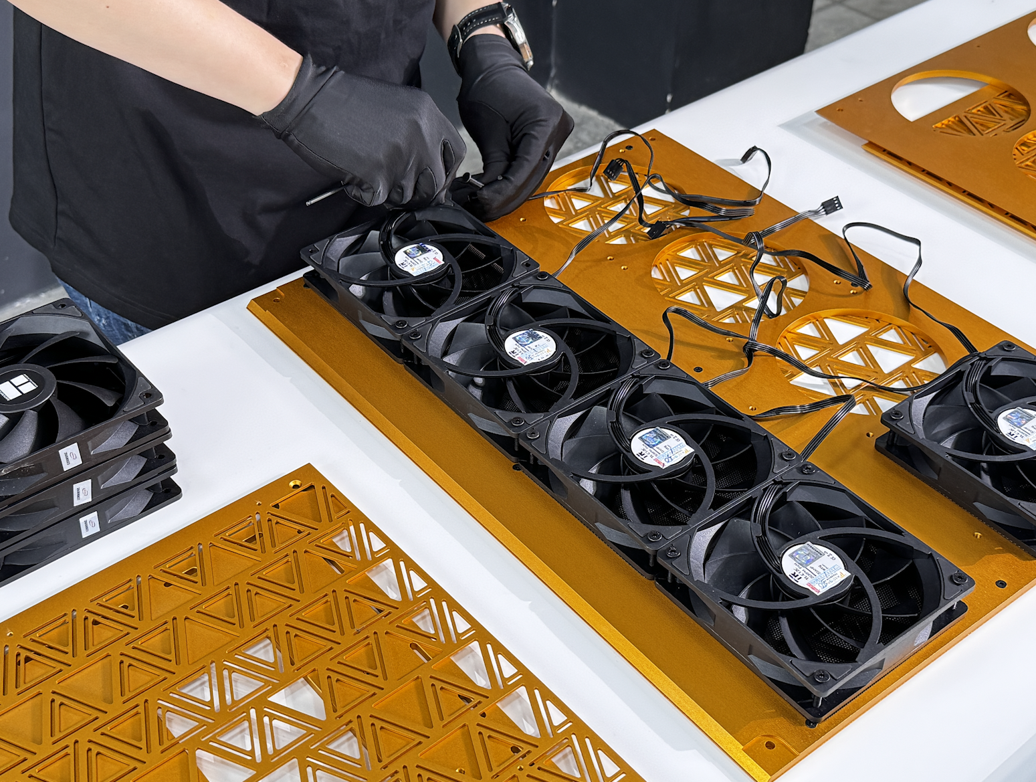
[picture p59: Photos/8GPU/Assembly/5.png]
| 5 | Install the remaining fans. |  |
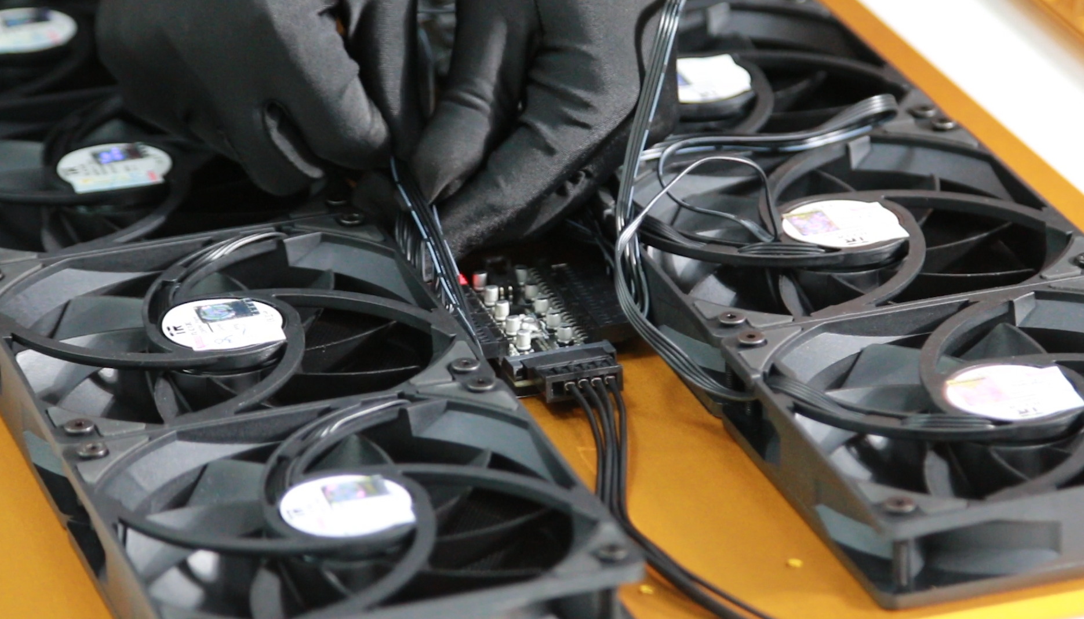
[picture p60: Photos/8GPU/Assembly/6.png]
| 6 | Connect all fans to the control board. |  |
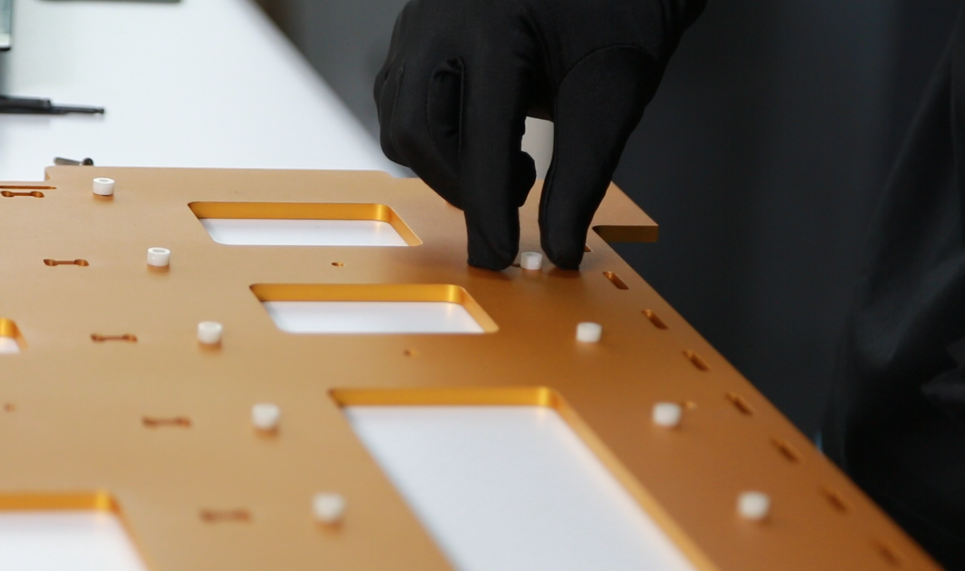
[picture p61: Photos/8GPU/Assembly/7.png]
| 7 | Place plastic spacers in position on “Part 2 – CPU Plate”. |  |
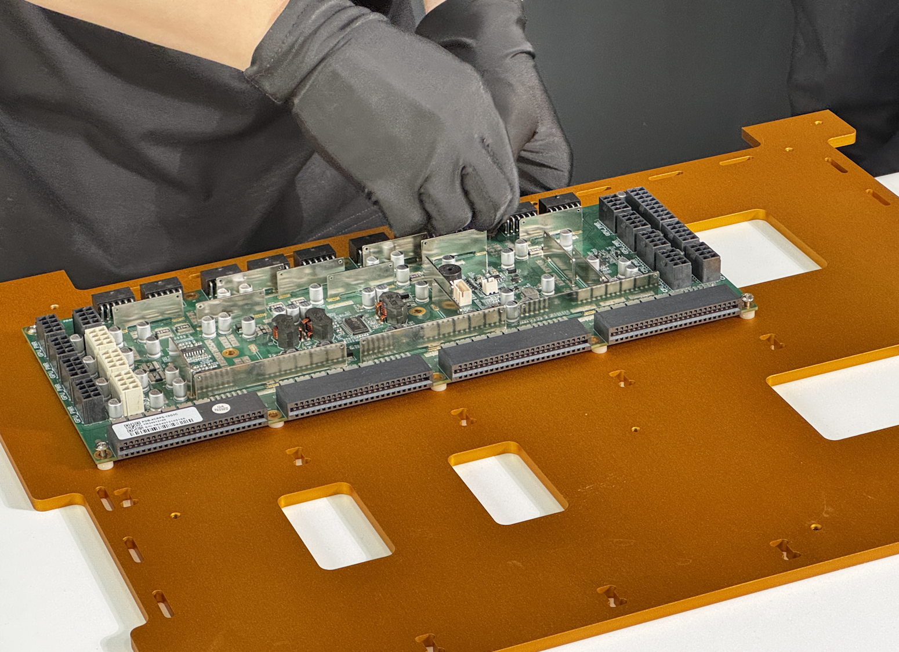
[picture p62: Photos/8GPU/Assembly/8.png]
| 8 | Fix the PSU board to “Part 2 – CPU Plate”. |  |
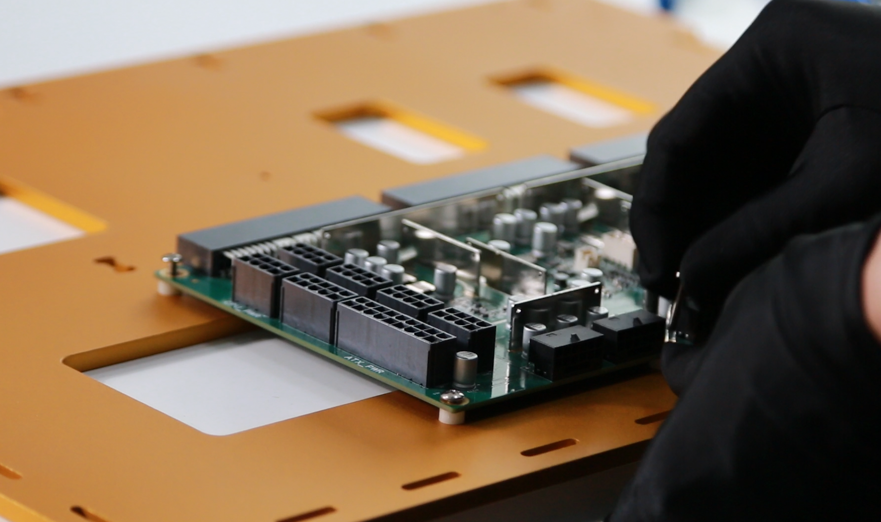
[picture p63: Photos/8GPU/Assembly/9.png]
| 9 | Insert all screws, but do not tighten them yet. |  |
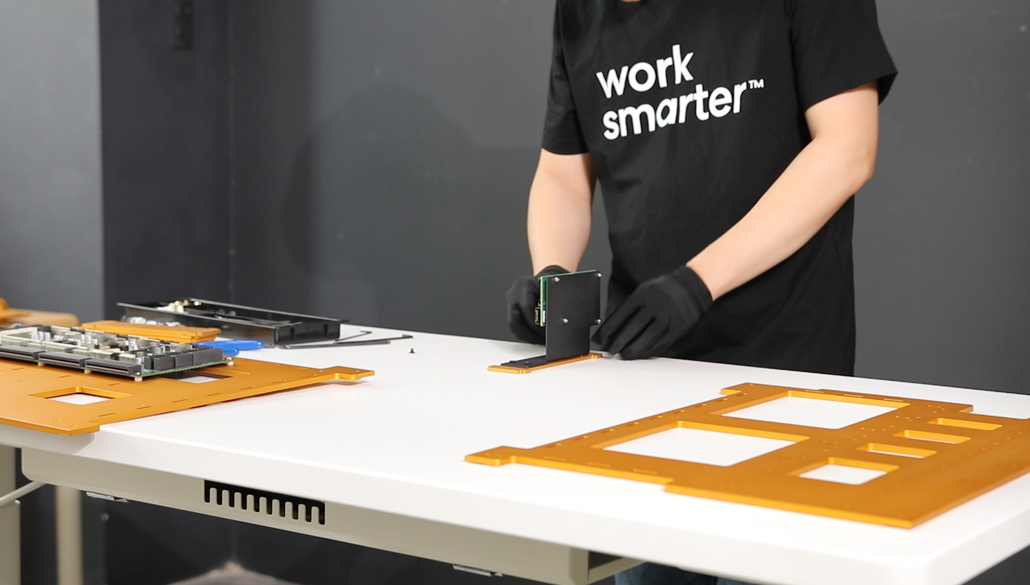
[picture p64: Photos/8GPU/Assembly/10.png]
| 10 | Assemble the Ethernet board into “Part 10 – PSU Mount”. |  |
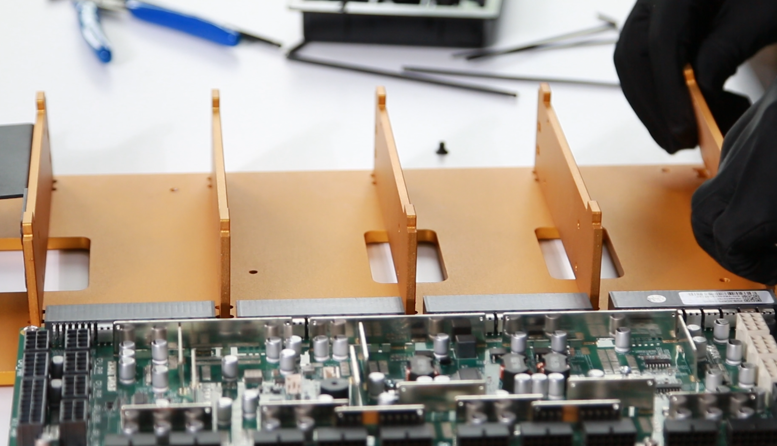
[picture p65: Photos/8GPU/Assembly/11.png]
| 11 | Place “Part 10 – PSU Mount” into position. |  |
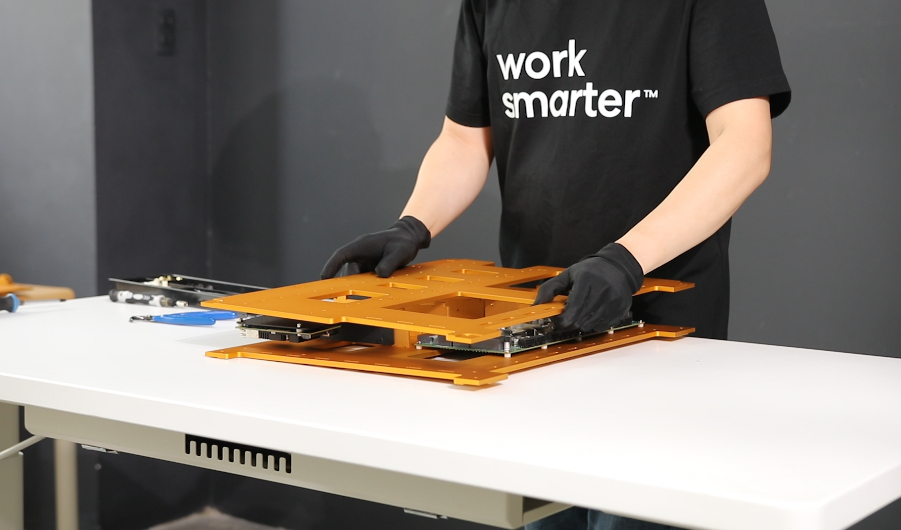
[picture p66: Photos/8GPU/Assembly/12.png]
| 12 | Place “Part 1 – GPU Plate” on top. |  |
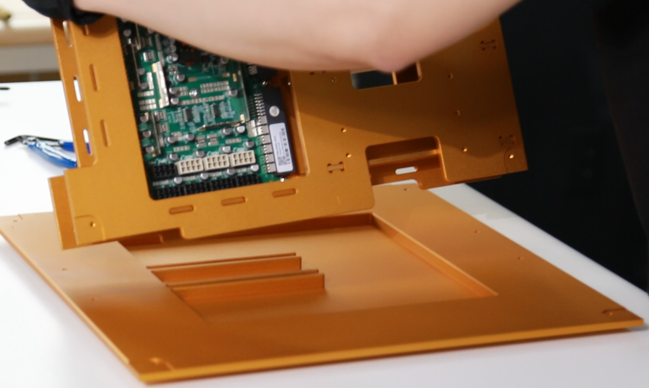
[picture p67: Photos/8GPU/Assembly/13.png]
| 13 | Place all middle parts onto “Part 5 – Bottom”. |  |
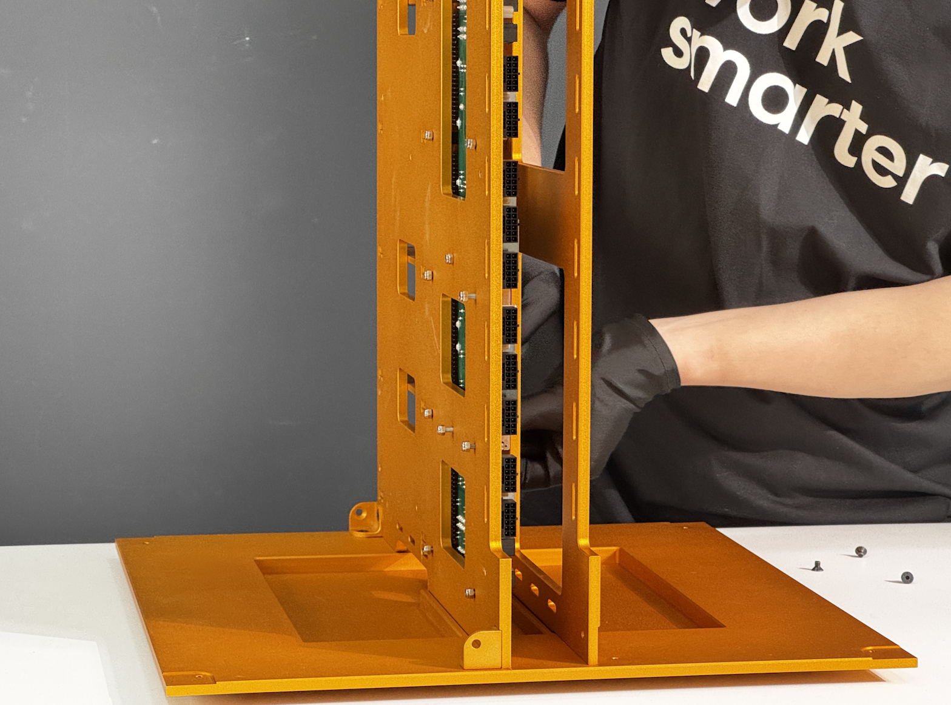
[picture p68: Photos/8GPU/Assembly/14.png]
| 14 | Place all support mounts into position. |  |
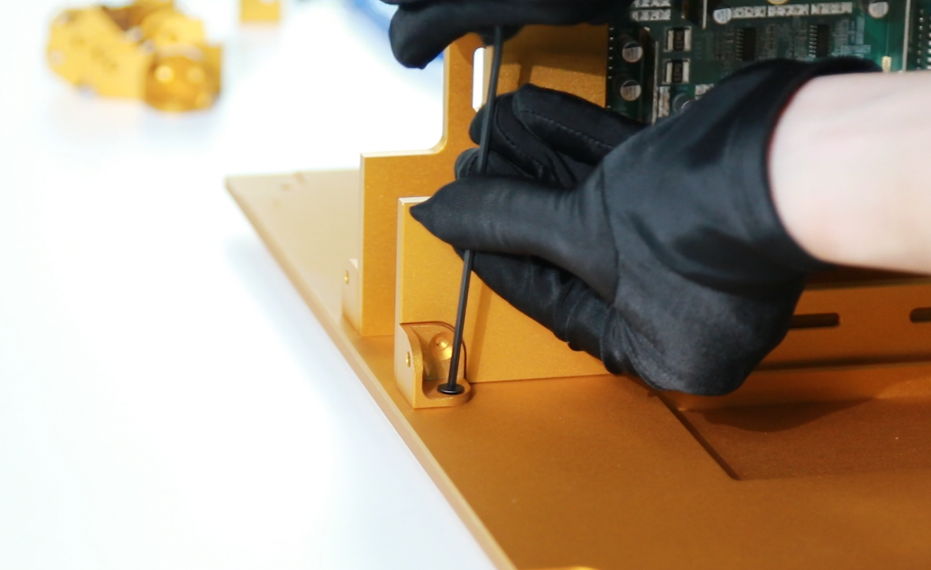
[picture p69: Photos/8GPU/Assembly/15.png]
| 15 | Secure with M4 × 8 mm screws. |  |
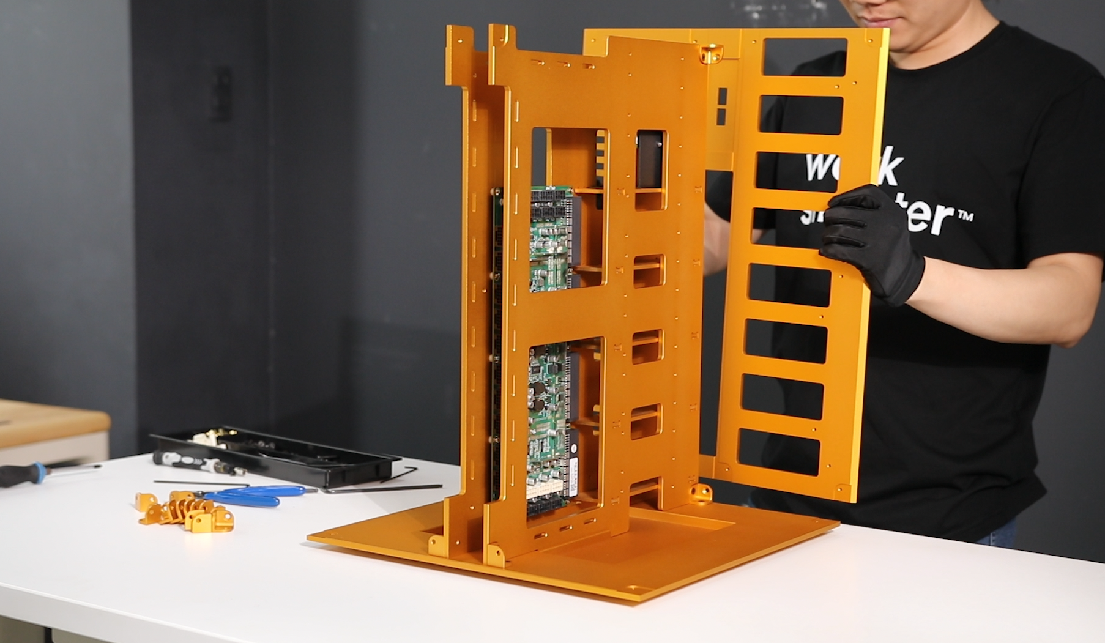
[picture p70: Photos/8GPU/Assembly/16.png]
| 16 | Place “Part 4 – Back” into position and secure it with M4 screws. |  |
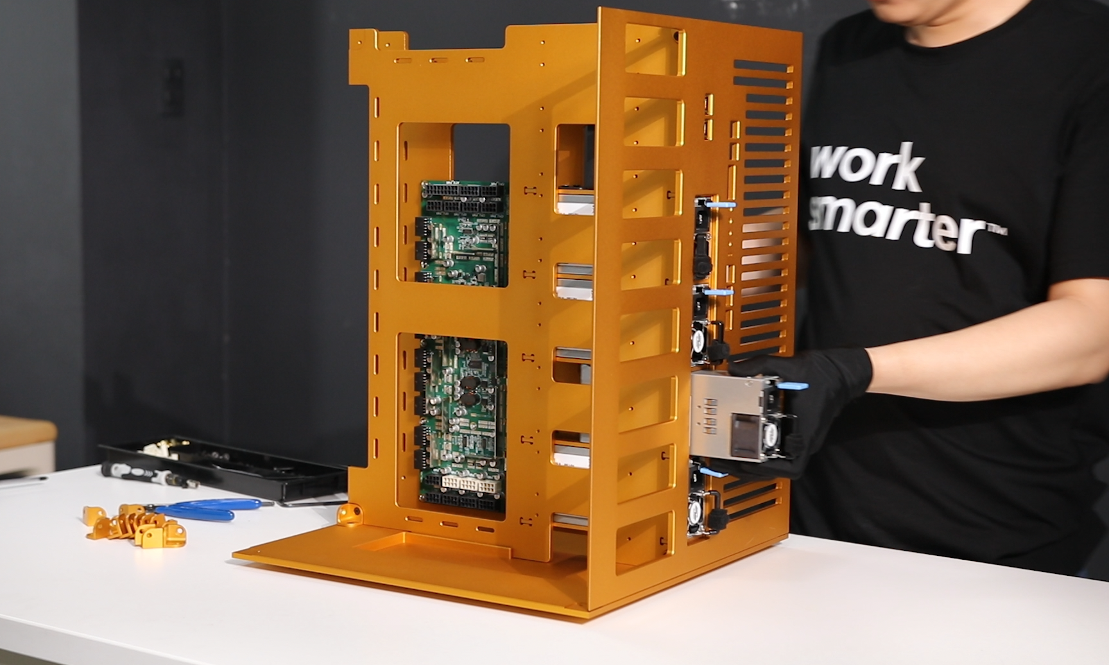
[picture p71: Photos/8GPU/Assembly/17.png]
| 17 | Install all four PSUs into position and connect them to the PSU board. |  |
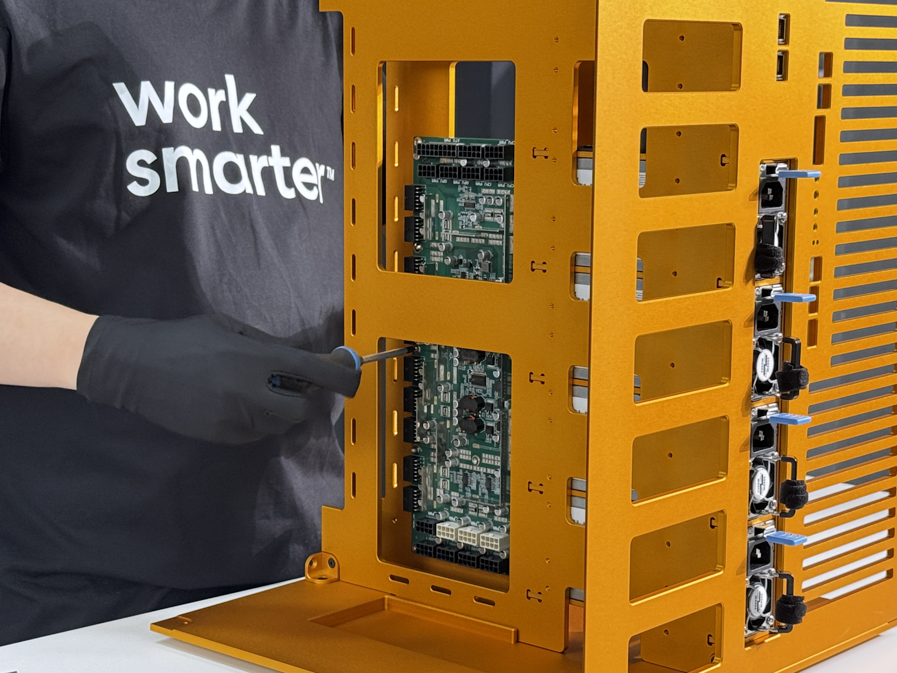
[picture p72: Photos/8GPU/Assembly/18.png]
| 18 | Tighten all screws on the PSU board. |  |
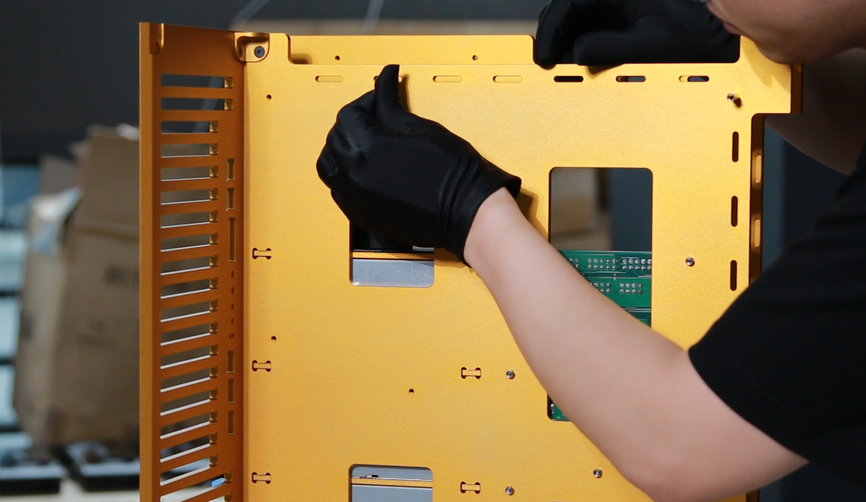
[picture p73: Photos/8GPU/Assembly/19.png]
| 19 | Install M4 × 15 mm copper spacers into the M4 holes on the other side. |  |
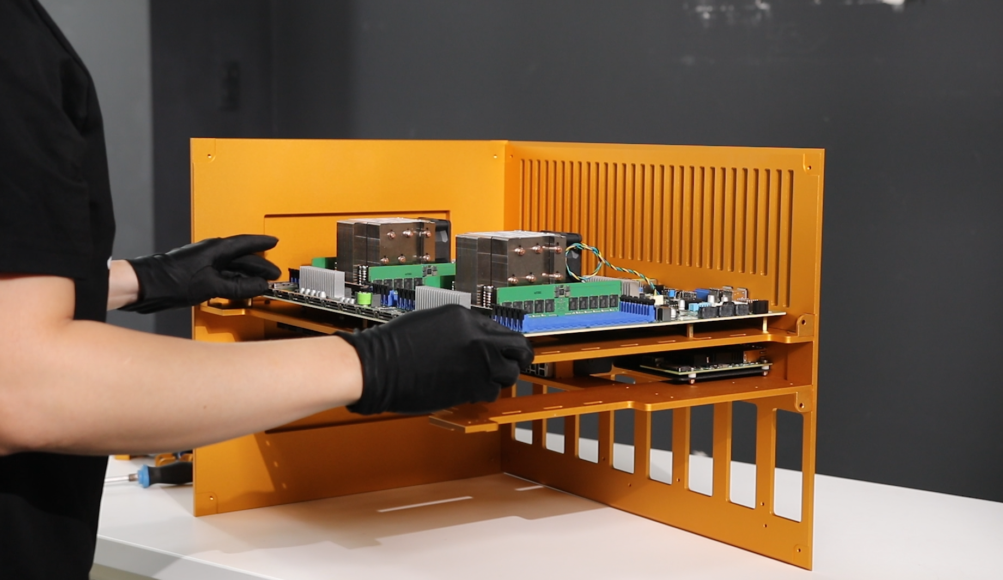
[picture p74: Photos/8GPU/Assembly/20.png]
| 20 | Place the “Motherboard GENOA2D24G-2L+” into position. |  |
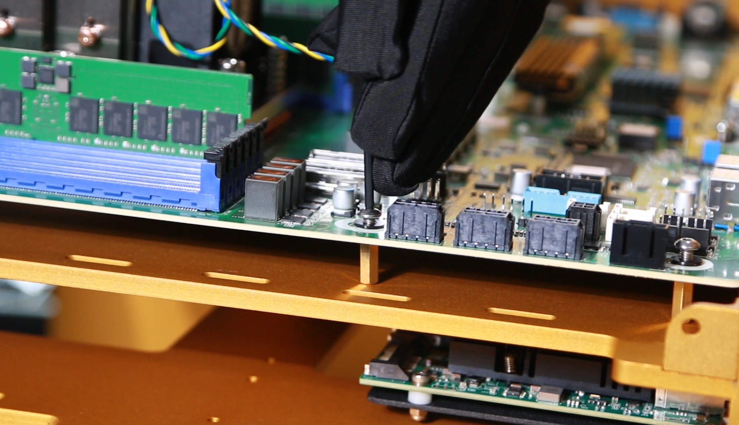
[picture p75: Photos/8GPU/Assembly/21.png]
| 21 | Secure the motherboard to “Part 2 – CPU Plate” using M3 screws. |  |
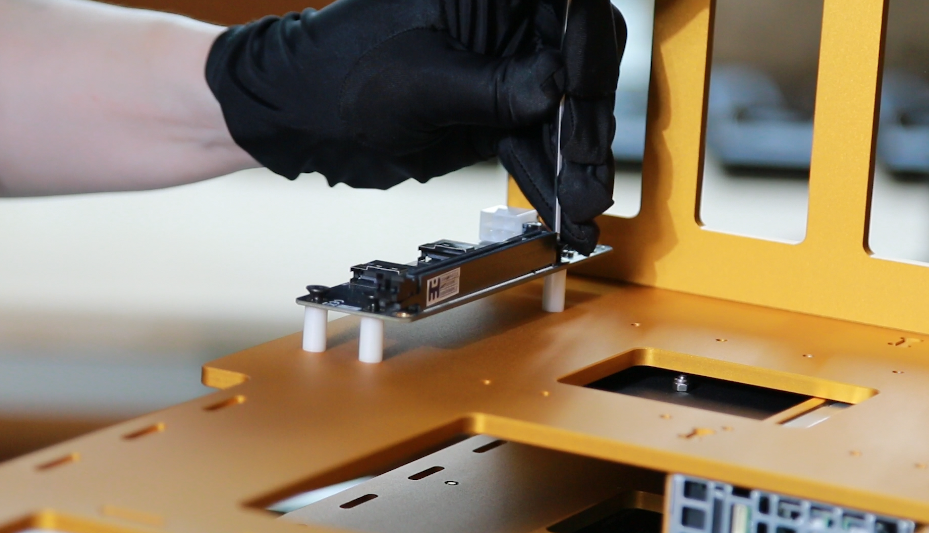
[picture p76: Photos/8GPU/Assembly/22.png]
| 22 | Place 20 mm plastic spacers under the PCI board and secure them with M4 screws. |  |
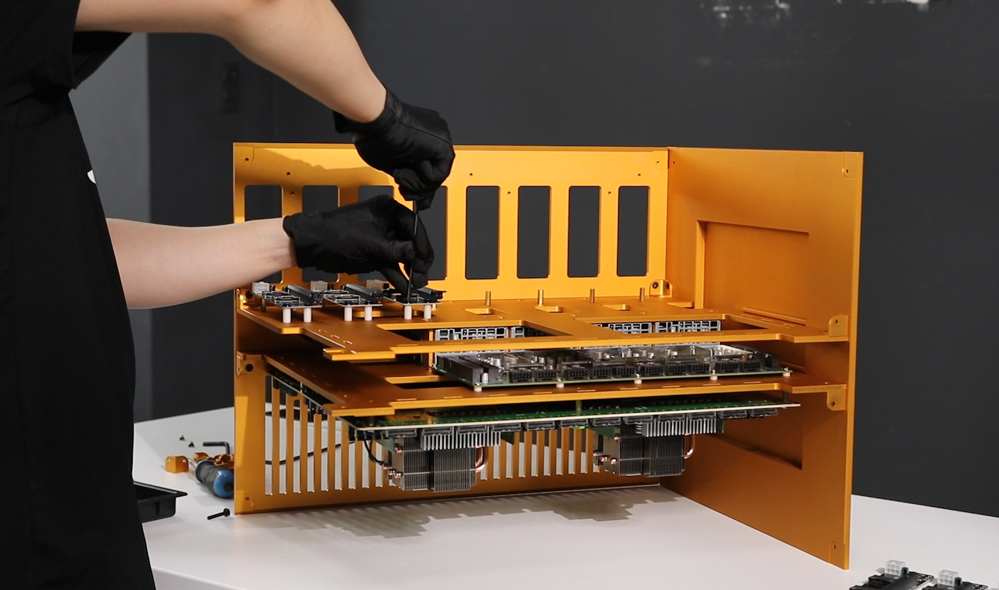
[picture p77: Photos/8GPU/Assembly/23.png]
| 23 | Install the remaining components. |  |
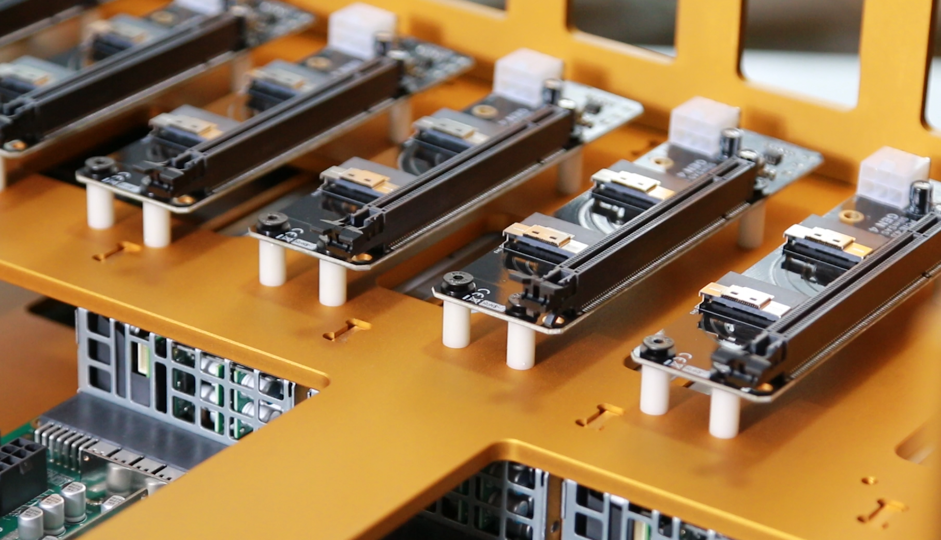
[picture p78: Photos/8GPU/Assembly/24.png]
| 24 | Just a photo  |  |
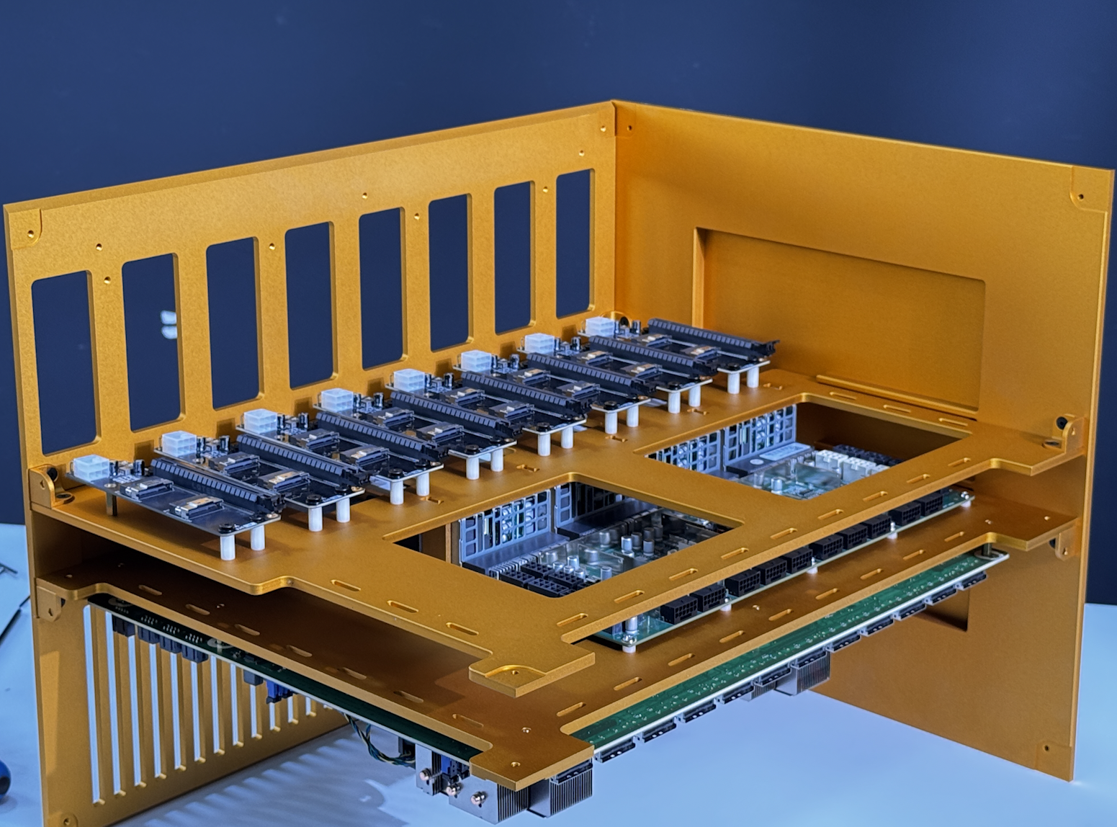
[picture p79: Photos/8GPU/Assembly/25.png]
| 25 | Just a photo  |  |
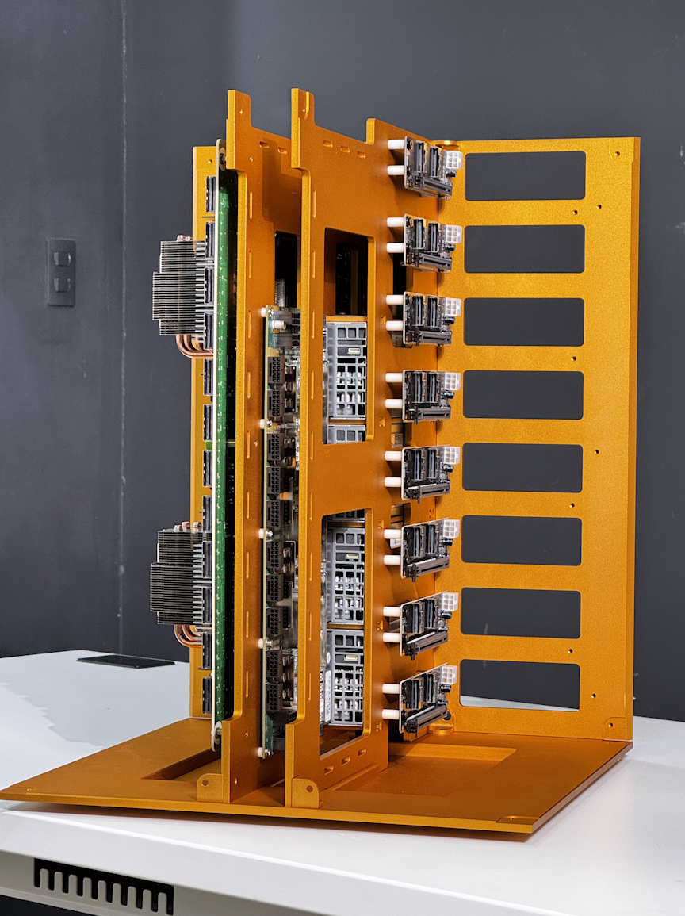
[picture p80: Photos/8GPU/Assembly/26.png]
| 26 | Place the assembled parts upright. |  |
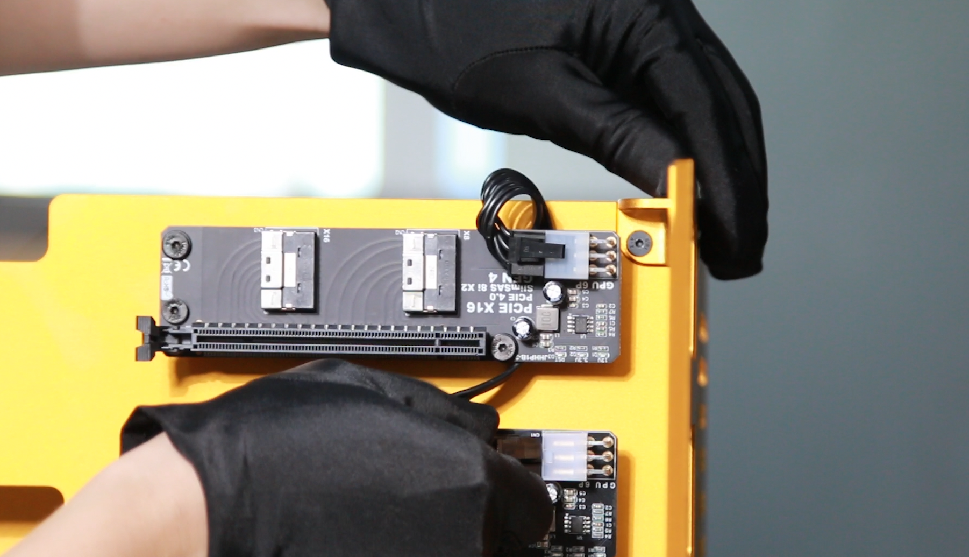
[picture p81: Photos/8GPU/Assembly/27.png]
| 27 | Connect the PCI board cable to the motherboard. |  |
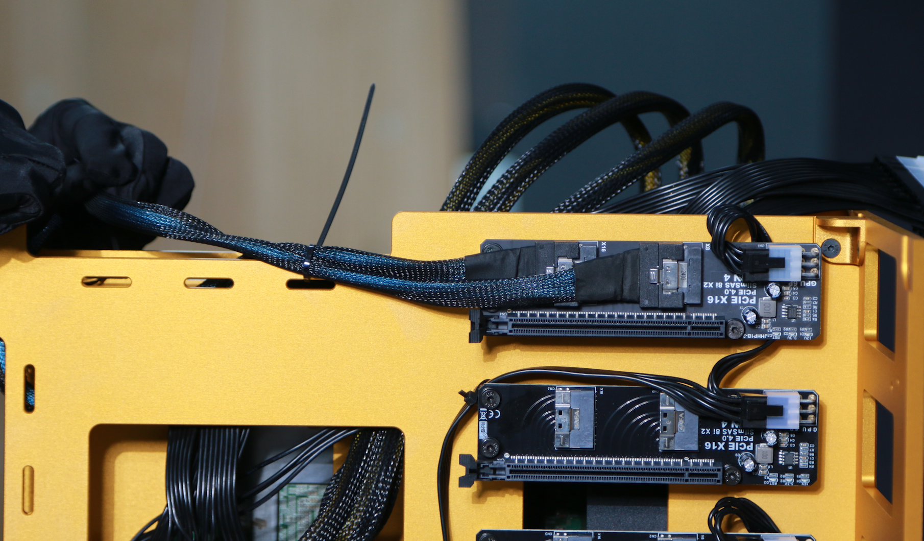
[picture p82: Photos/8GPU/Assembly/28.png]
| 28 | Use zip ties to organize cables. |  |
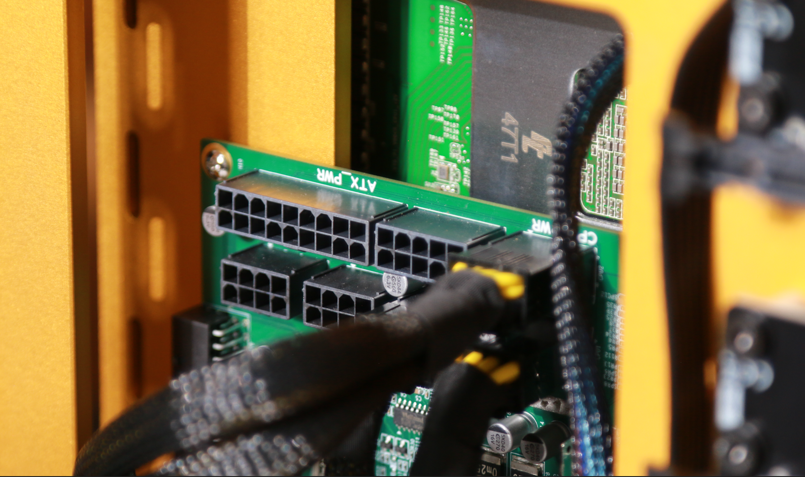
[picture p83: Photos/8GPU/Assembly/29.png]
| 29 | Connect the power cable to the motherboard. |  |
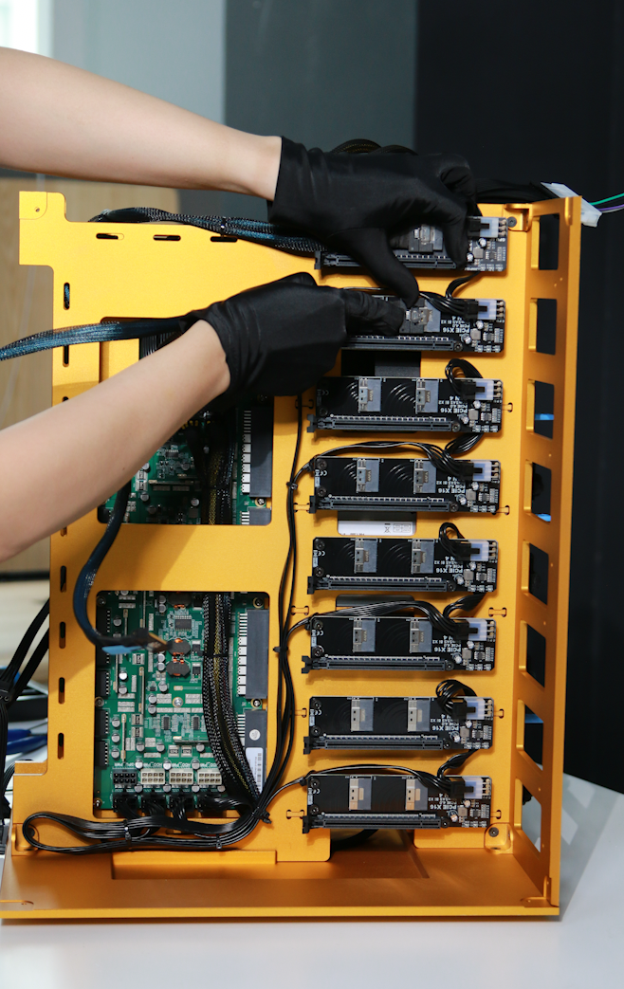
[picture p84: Photos/8GPU/Assembly/30.png]
| 30 | Connect MCIO cable to MCIO adapter |  |
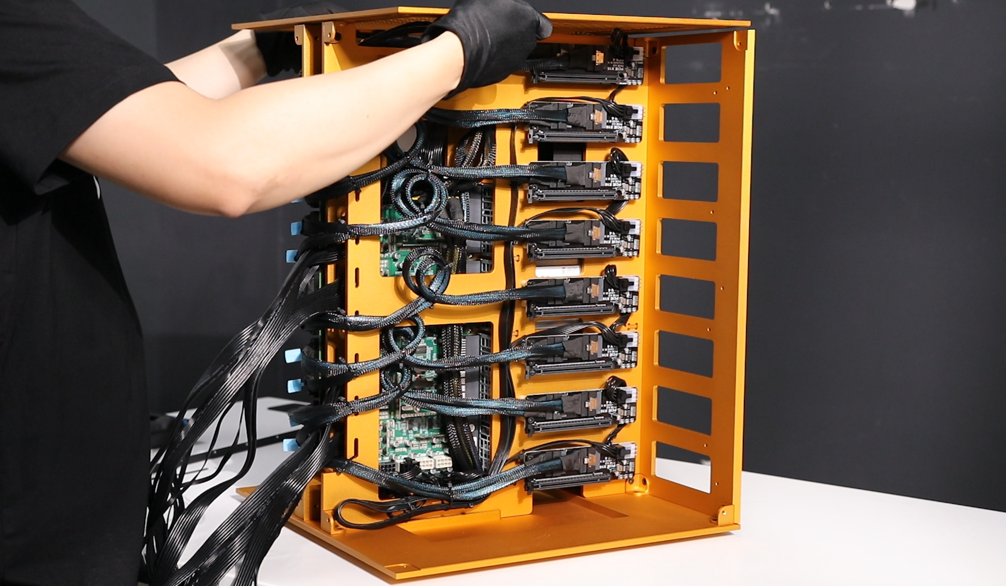
[picture p85: Photos/8GPU/Assembly/31.png]
| 31 | Place “Part 6 – Top” into position and secure it with M4 screws and the support plate. |  |
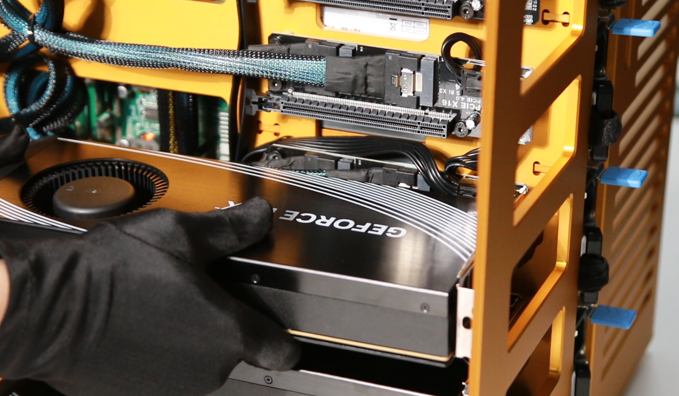
[picture p86: Photos/8GPU/Assembly/32.png]
| 32 | Install 8 GPUs. |  |
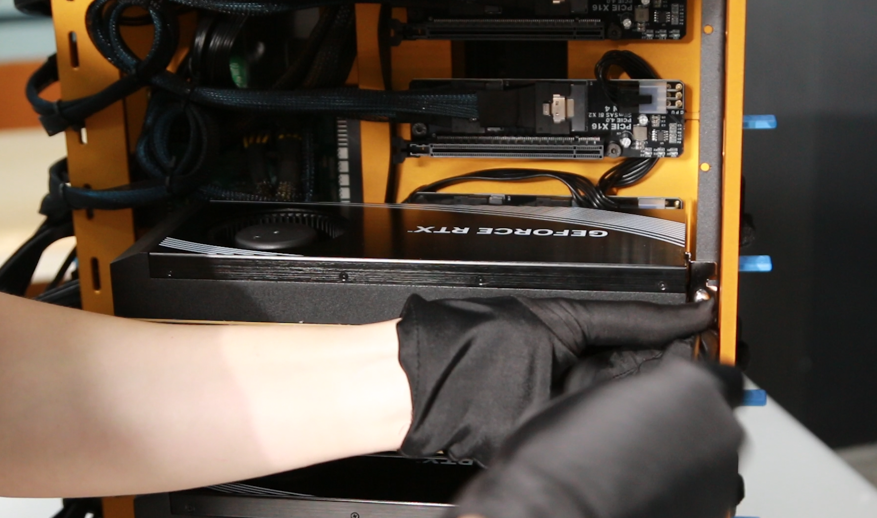
[picture p87: Photos/8GPU/Assembly/33.png]
| 33 | Secure the GPUs to the support rail. |  |
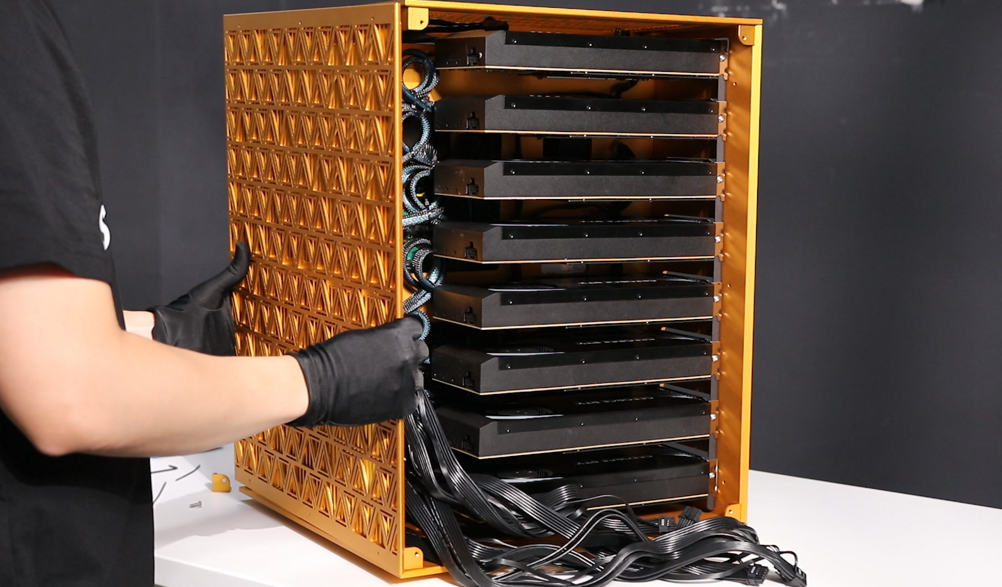
[picture p88: Photos/8GPU/Assembly/34.png]
| 34 | Organize the power supply cables. |  |
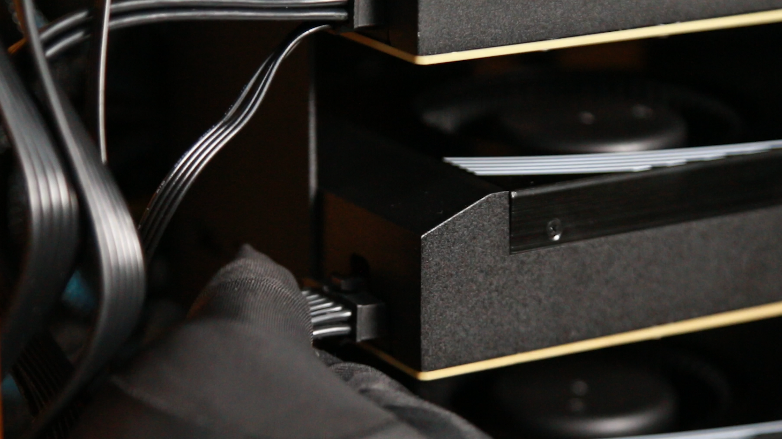
[picture p89: Photos/8GPU/Assembly/35.png]
| 35 | Connect the power supply cables. |  |
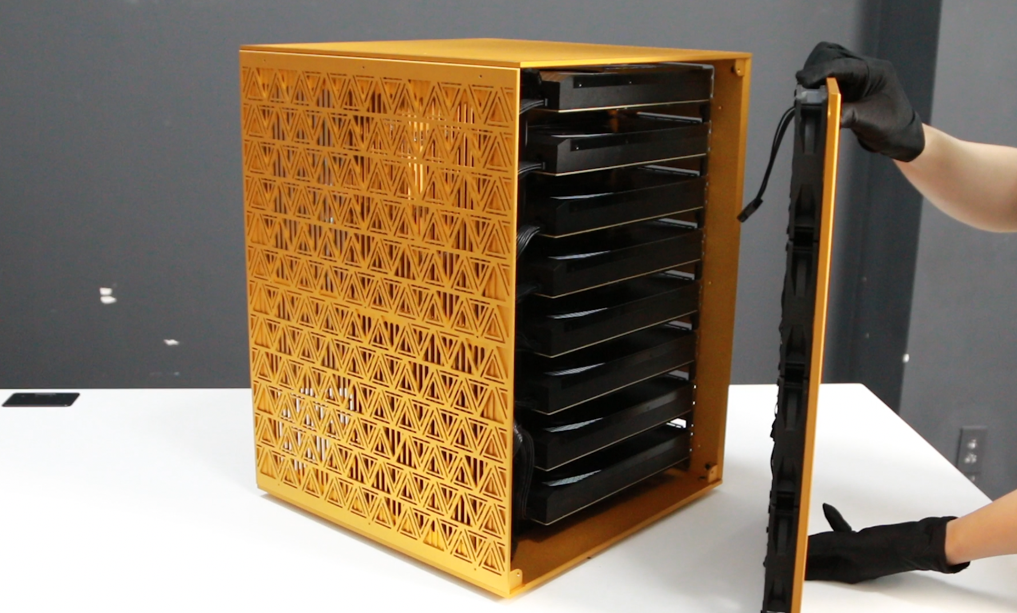
[picture p90: Photos/8GPU/Assembly/36.png]
| 36 | Connect the fan board cable, then place the fan board into position. |  |
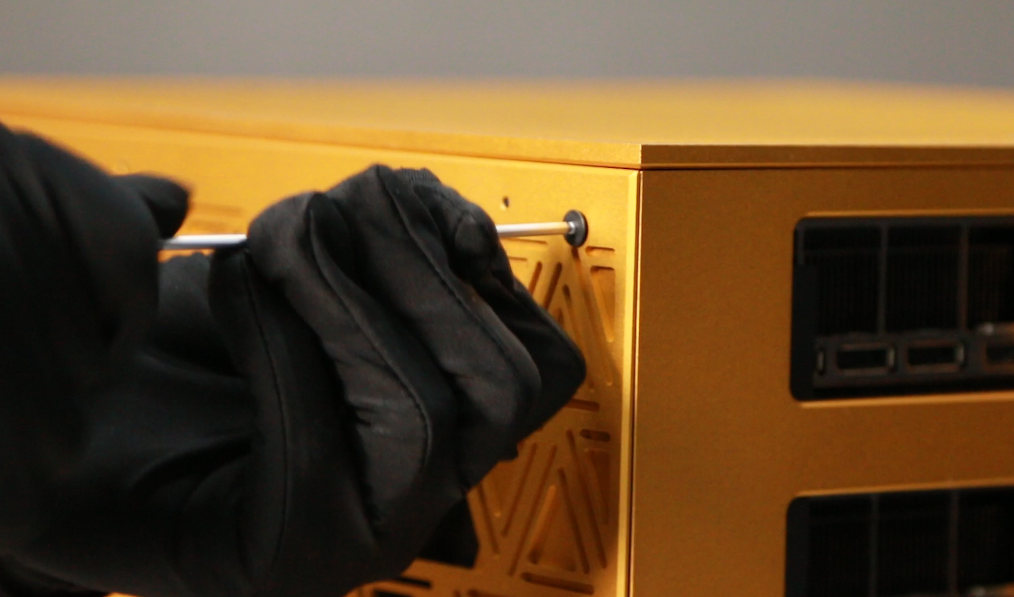
[picture p91: Photos/8GPU/Assembly/37.png]
| 37 | Secure “Part 7 – Side”. |  |
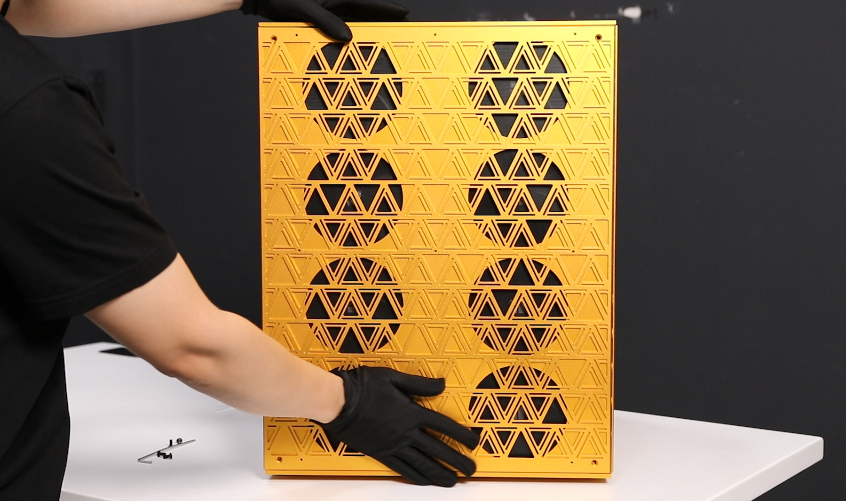
[picture p92: Photos/8GPU/Assembly/38.png]
| 38 | Repeat for the other side. |  |
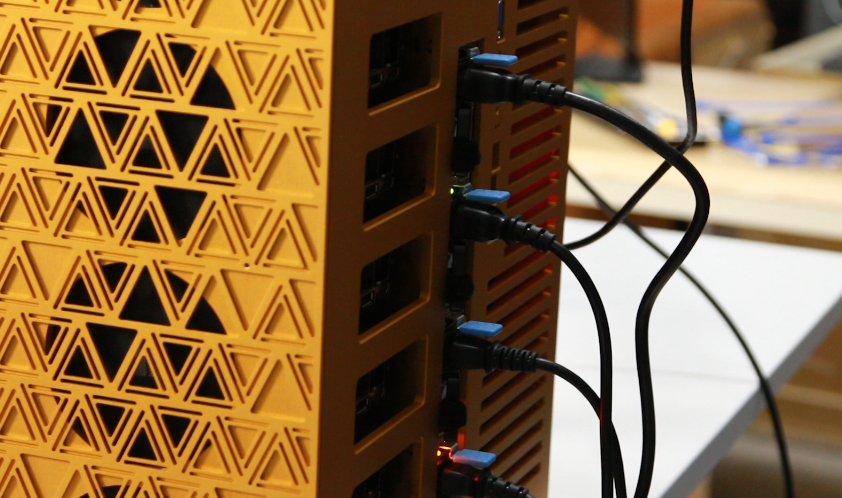
[picture p93: Photos/8GPU/Assembly/39.png]
| 39 | Connect the main power supply. |  |

---
