bhardwajRahul/autonomous-computer/2x-rtx5090/docs/Assembly.md

| Step | Description | Image |
|---|---|---|
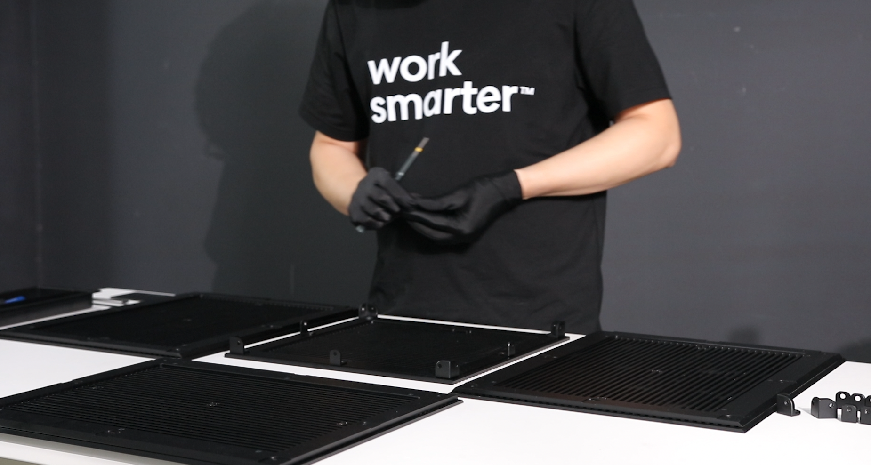
[picture p94: 2x-rtx5090/photos/2gpu/assembly/1.png]
| 1 | Prepare housing. |  |
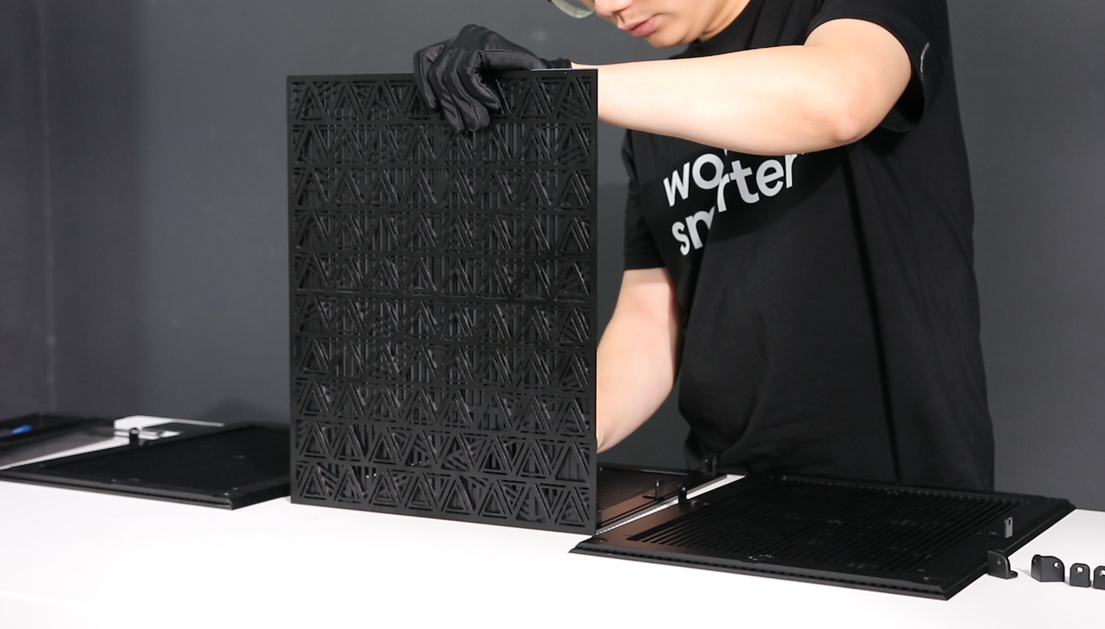
[picture p95: 2x-rtx5090/photos/2gpu/assembly/2.png]
| 2 | Assembly side and base of housing. |  |
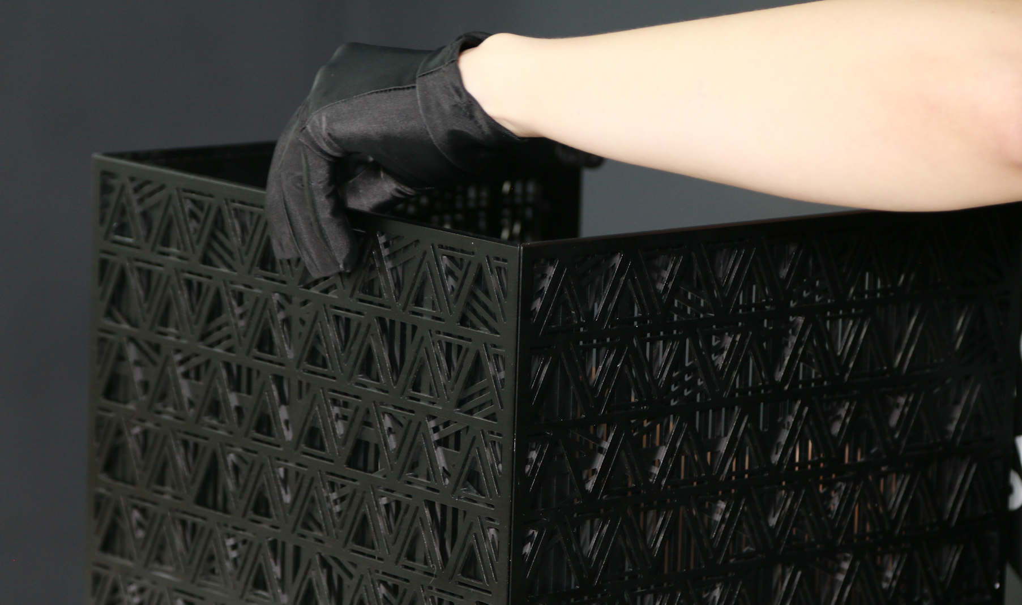
[picture p96: 2x-rtx5090/photos/2gpu/assembly/3.png]
| 3 | Assembly other side to base of housing. |  |
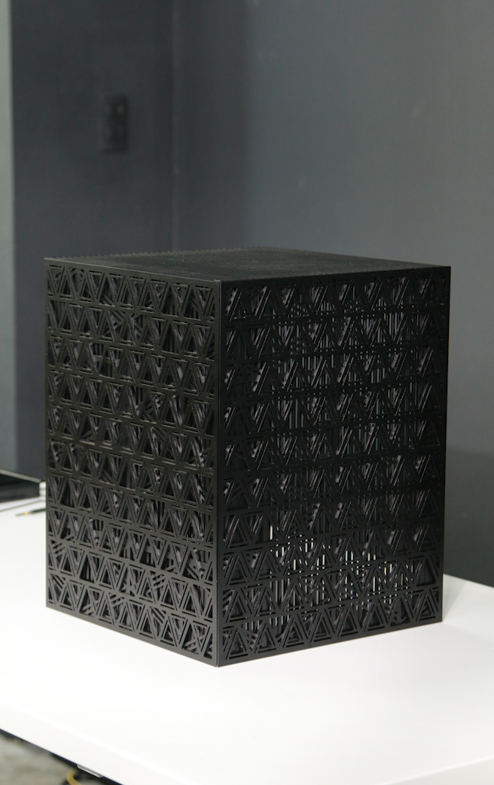
[picture p97: 2x-rtx5090/photos/2gpu/assembly/4.png]
| 4 | Assembly top to housing. |  |
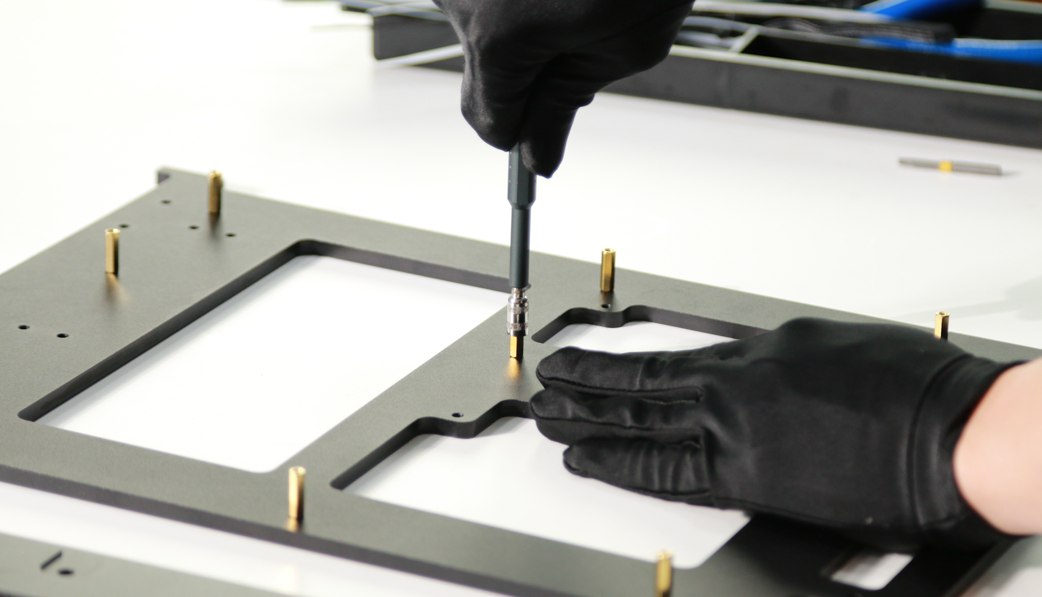
[picture p98: 2x-rtx5090/photos/2gpu/assembly/5.png]
| 5 | Attach brass hex standoff to the behind side. |  |
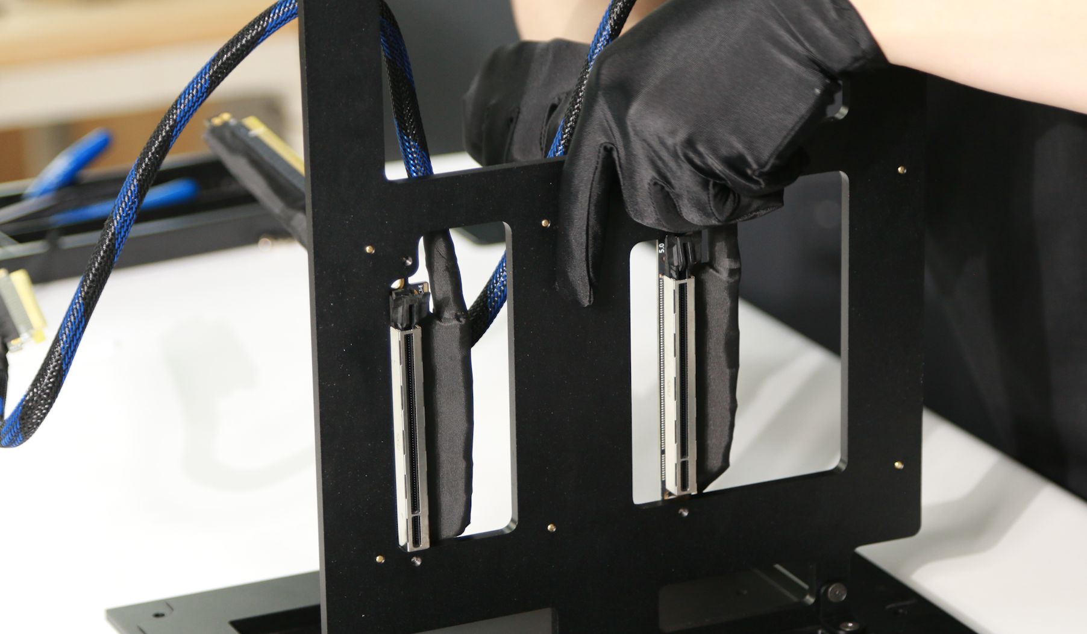
[picture p99: 2x-rtx5090/photos/2gpu/assembly/6.png]
| 6 | Assembly PCIe riser to the mount. |  |
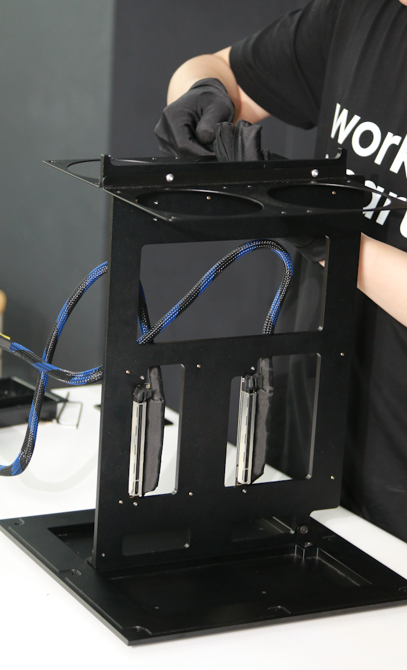
[picture p100: 2x-rtx5090/photos/2gpu/assembly/7.png]
| 7 | Attach the fan fixed plate to the mount. |  |
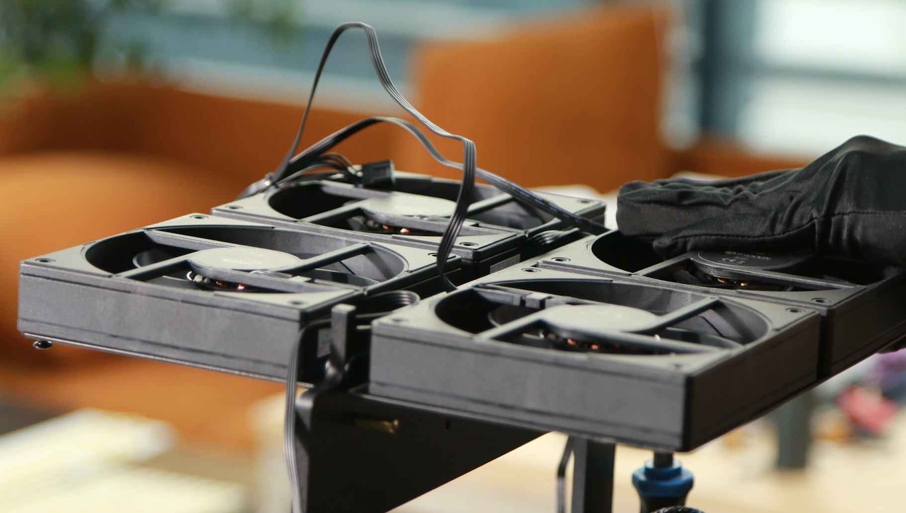
[picture p101: 2x-rtx5090/photos/2gpu/assembly/8.png]
| 8 | Assembly fans to the fan fixed plate. |  |
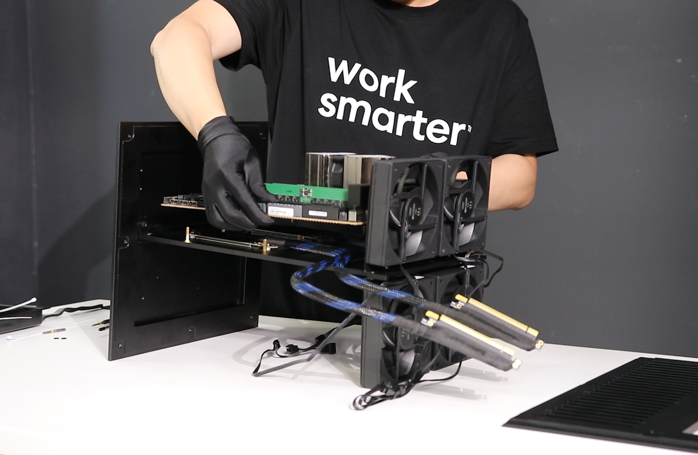
[picture p102: 2x-rtx5090/photos/2gpu/assembly/9.png]
| 9 | Assembly motherboard to the mount. |  |
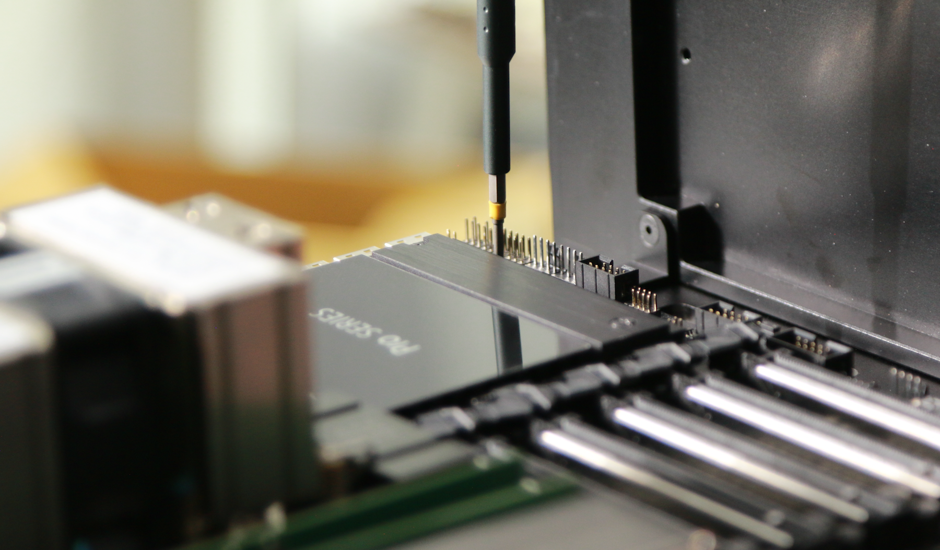
[picture p103: 2x-rtx5090/photos/2gpu/assembly/10.png]
| 10 | Tight the motherboard to the mount. |  |
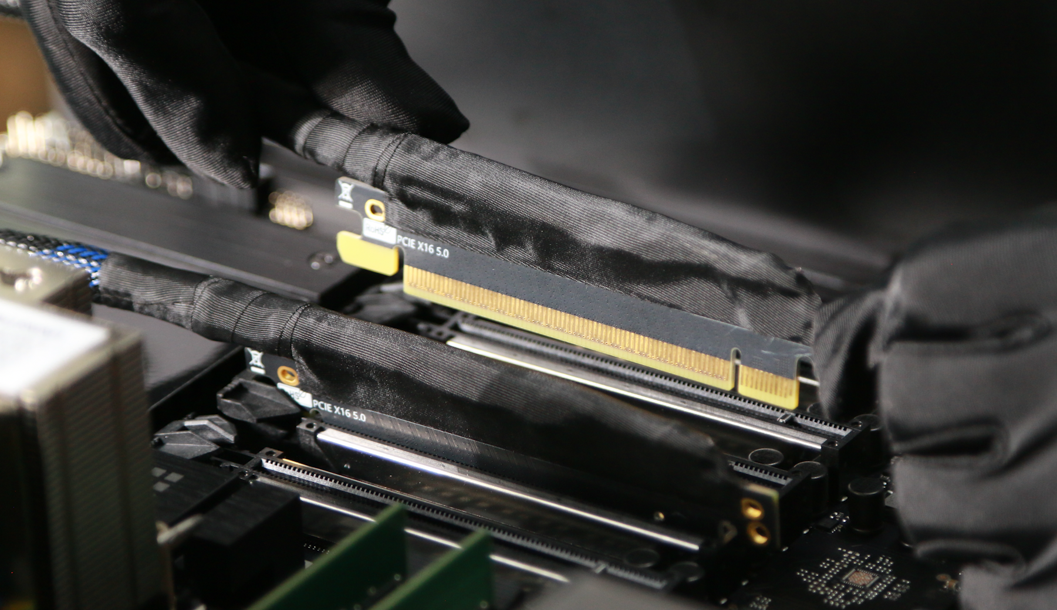
[picture p104: 2x-rtx5090/photos/2gpu/assembly/11.png]
| 11 | Attach the PCIe riser to motherboard . |  |
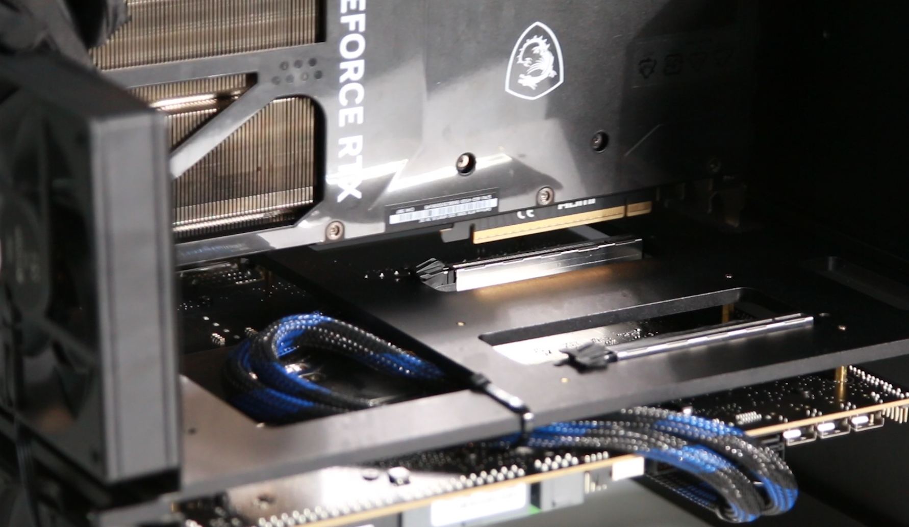
[picture p105: 2x-rtx5090/photos/2gpu/assembly/12.png]
| 12 | Attach GPUs to the female of PCIe riser. |  |
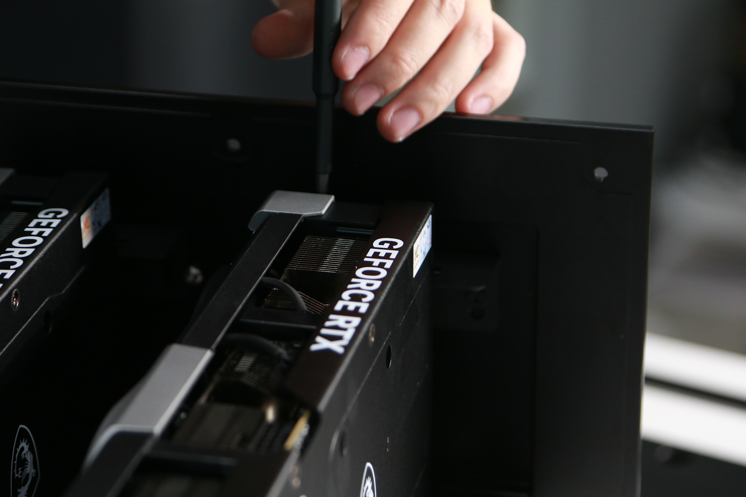
[picture p106: 2x-rtx5090/photos/2gpu/assembly/13.png]
| 13 | Tight the GPUs to the mount. |  |
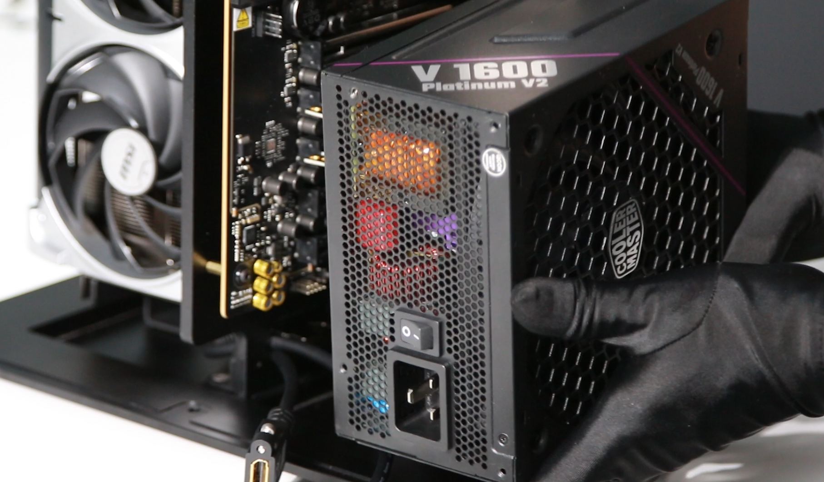
[picture p107: 2x-rtx5090/photos/2gpu/assembly/14.png]
| 14 | Attach the PSU to the base. |  |
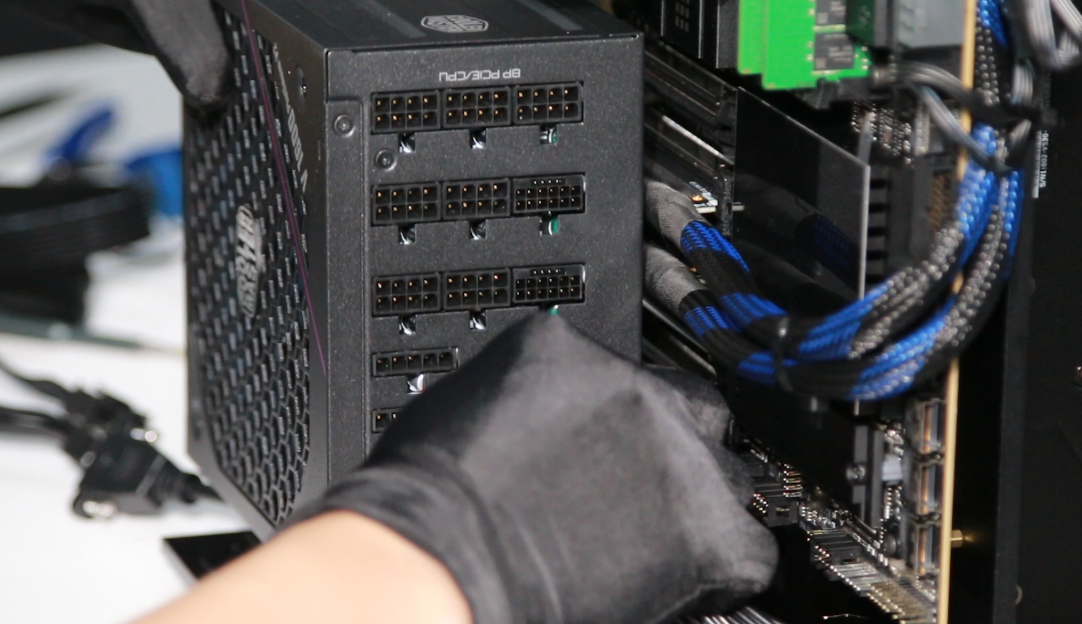
[picture p108: 2x-rtx5090/photos/2gpu/assembly/15.png]
| 15 | Connect the cables to the PSU side. |  |
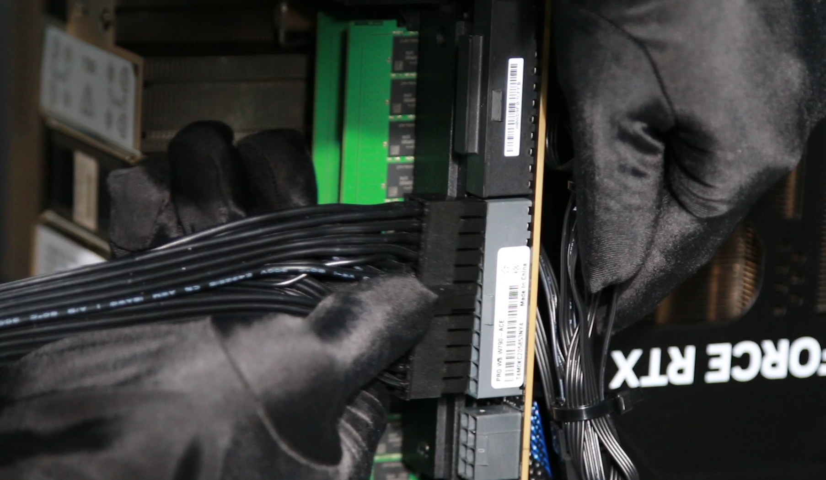
[picture p109: 2x-rtx5090/photos/2gpu/assembly/16.png]
| 16 | Connect ATX cable to motherboard. |  |
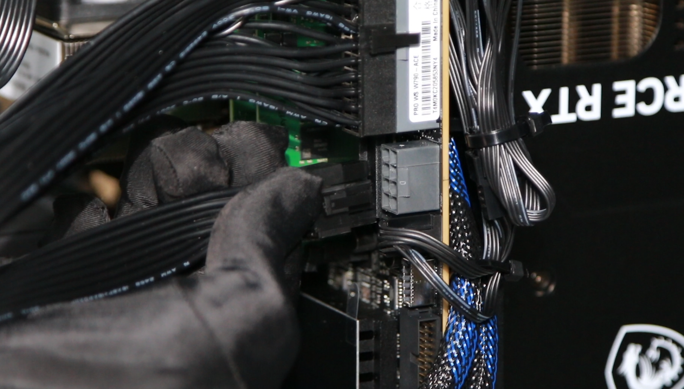
[picture p110: 2x-rtx5090/photos/2gpu/assembly/17.png]
| 17 | Connect 8 pin connector to motherboard. |  |
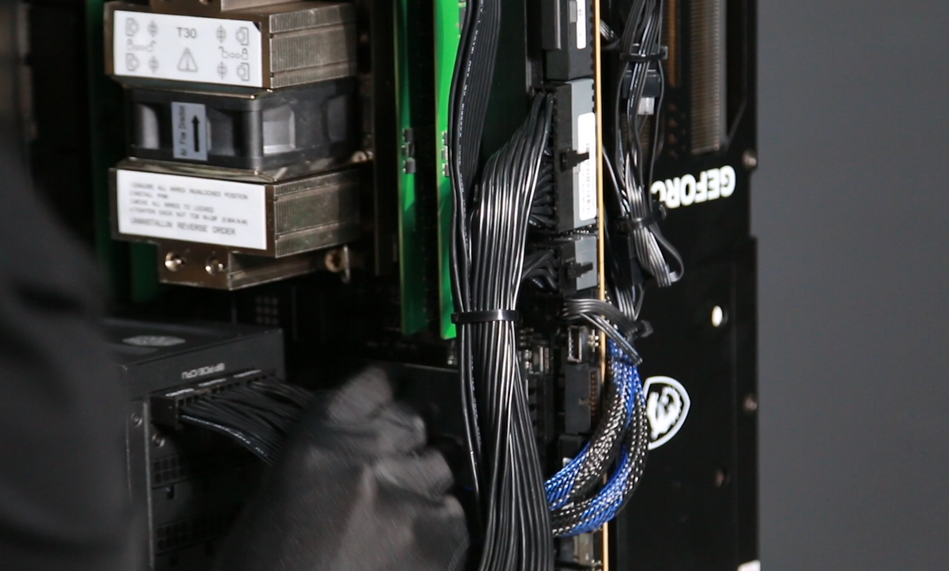
[picture p111: 2x-rtx5090/photos/2gpu/assembly/18.png]
| 18 | Connect the CPU fan to motherboard. |  |
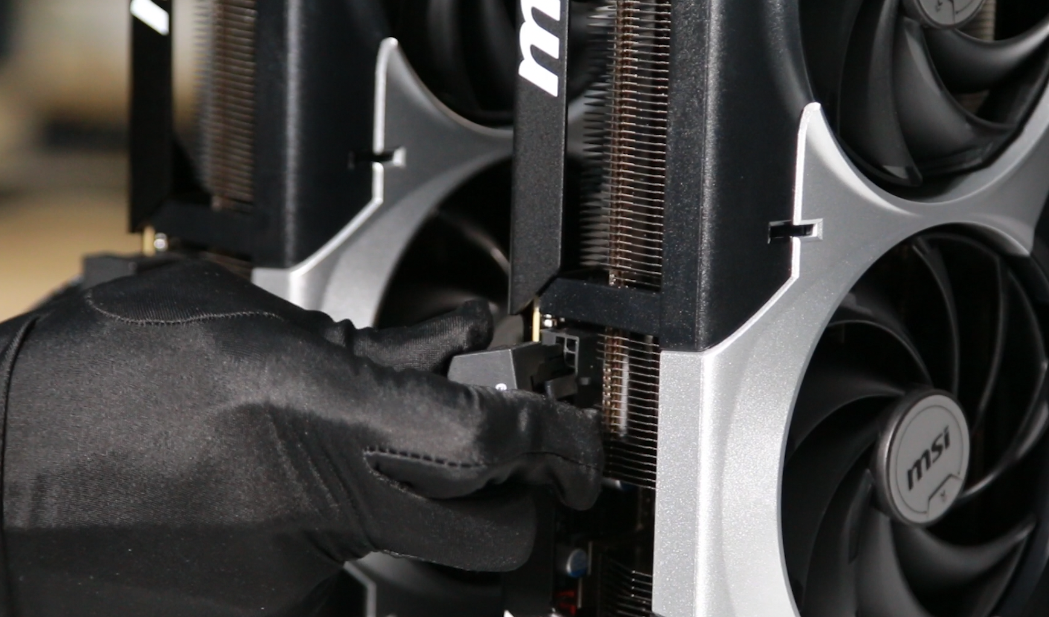
[picture p112: 2x-rtx5090/photos/2gpu/assembly/19.png]
| 19 | Connect the 12 pin cable to GPUs. |  |
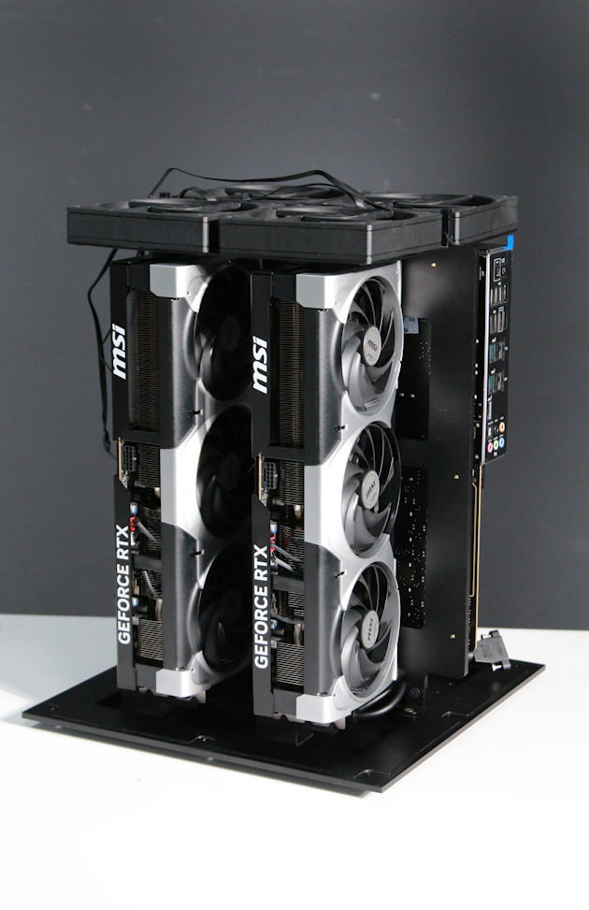
[picture p113: 2x-rtx5090/photos/2gpu/assembly/20.png]
| 20 | Finish assembly the EE component inside. |  |
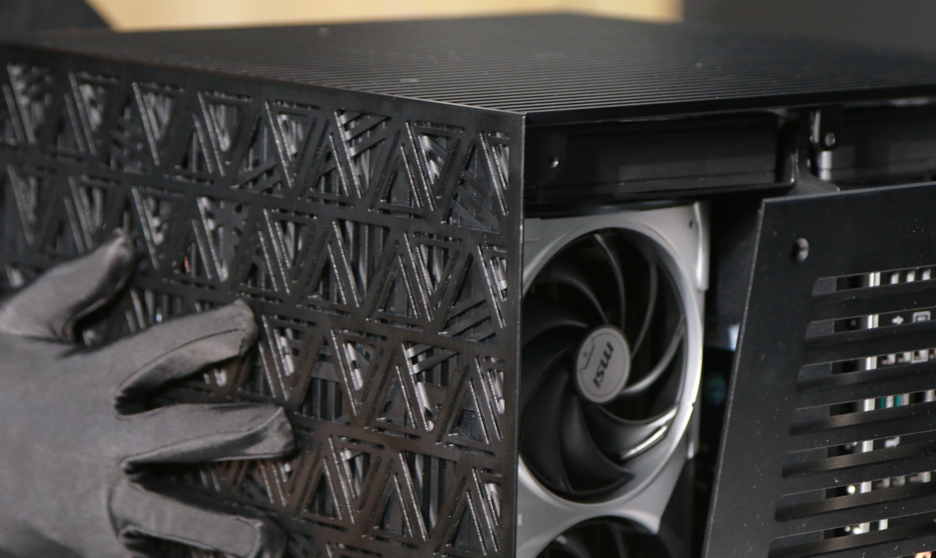
[picture p114: 2x-rtx5090/photos/2gpu/assembly/21.png]
| 21 | Assembly the side of the housing . |  |
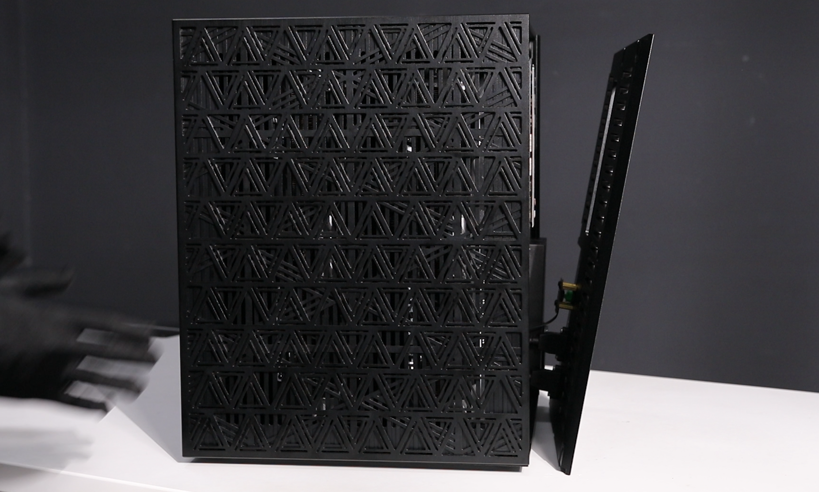
[picture p115: 2x-rtx5090/photos/2gpu/assembly/22.png]
| 22 | Continue with other side. |  |
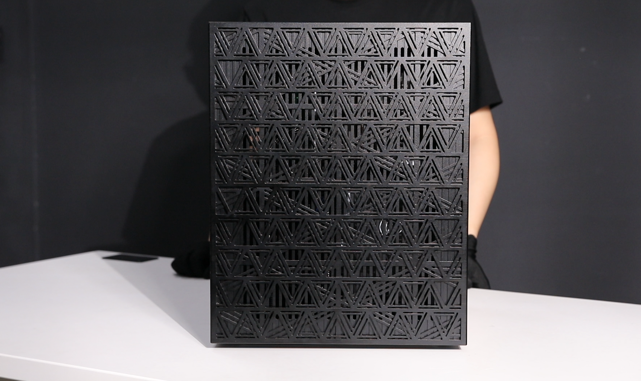
[picture p116: 2x-rtx5090/photos/2gpu/assembly/23.png]
| 23 | Continue with finish side. |  |

---
