bhardwajRahul/autonomous-computer/Photos/8GPU/Assembly/40.png

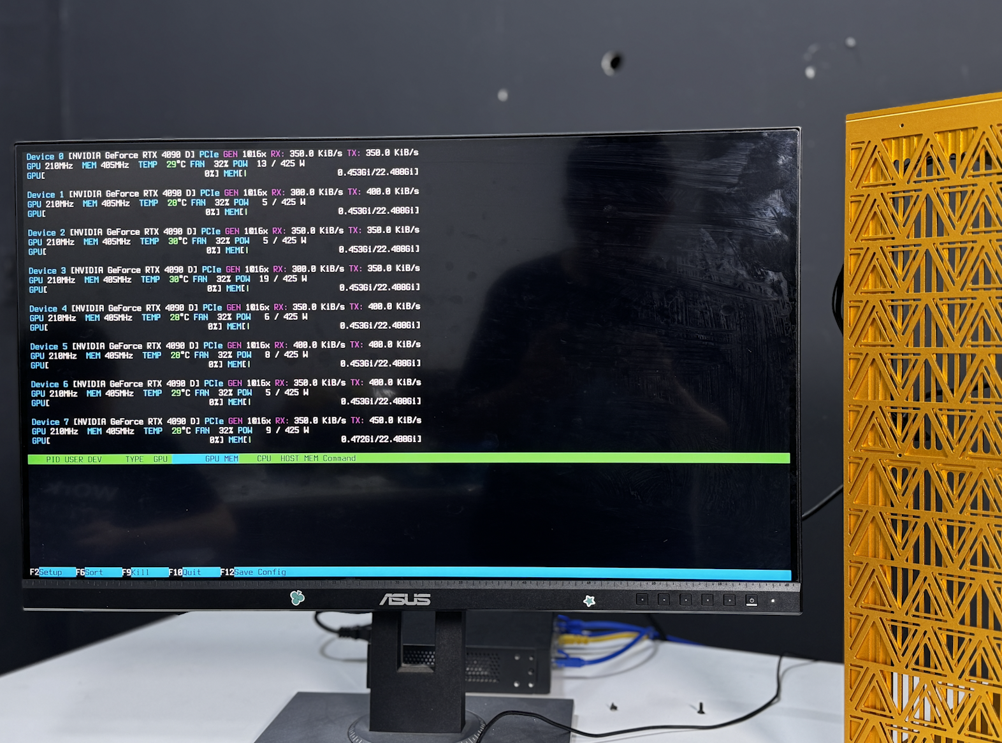
Photos/8GPU/Assembly/40.png
