bhardwajRahul/autonomous-computer/(commit log)

2026-06-01 Lowercase folder names in 2x-rtx5090, add build images to root README
    Renames all mixed-case directories in 2x-rtx5090 to lowercase
    (BOM→bom, Docs→docs, Photos→photos, Step_Models→step_models,
    stl-Models→stl-models) and updates internal README image paths.
    Replaces the flat table in the root README Other Builds section with
    side-by-side images linking to each build guide.
    [GPU mount 1.step, GPU mount 2.step, Part 1 - Side.step, Part 1 - Side.stl, Part 2 - Back.stl, Part 3 - Top.step, Part 3 - Top.stl, Part 4 - Bottom.step]
2026-07-05 README: intro in founder voice — short declaratives, one idea per line
2026-07-05 README: 'The future of AI is local' — 3 numbered reasons, 2 stack bullets
2026-07-05 README: drop '— electricity'
2026-07-05 Merge testing.md into setup.md: one 'BIOS tuning and GPU testing' guide
    Quick start gets step 5 (the guide) and step 6 (serve your models —
    any framework, or Grid); all build READMEs and CONTRIBUTING rewired.
2026-07-05 README: full NVIDIA names in build headings, dev spec tables from the site
    Hardware specs only — frameworks/delivery/warranty dropped. 2x keeps
    the CPU and PSU the repo guide actually documents (Xeon W5 / 1600 W).
2026-07-05 README: trim 5U chassis note
2026-07-05 README: Grid line — local AI network, not endpoint jargon
2026-07-05 2x-5090: match the root README treatment — clean title, step 6 Grid, serve-your-models section
2026-07-05 Build pages: same treatment as 2x — clean titles, spec bullets, step 6, Serve your models with Grid
2026-07-05 4x 6000: concise housing step
2026-07-06 4x-6000 & 4x-5090: real build photos, verified specs
    4x-6000: add studio photos (RTX PRO 6000 card, interior, data center); correct GPU to NVIDIA RTX PRO 6000 Blackwell Workstation Edition (ref board 900-5G144-2200-000); verify specs against hardware inventory — 384 GB GDDR7 ECC / 7,168 GB/s, 1x EPYC 9124, 990 EVO Plus, DDR5 @ 5600; flow-through (not blower); flesh out assembly/prep docs.
    4x-5090: add MSI RTX 5090 card photo (webp).
    Consistent 'Other builds' labels across pages.
2026-07-06 4x-5090: build out the full guide (draft)
    Expand README to match the 2x guide (Build it, BIOS notes, Testing, finished machine). Add BOM, component-checklist photo grid, and 23-step assembly. Housing reuses the shared 2x cube CAD; fix 4x dimensions to the 12.5in cube and drop the dual-chamber wording in the 4x and root READMEs.
    Component images are representative placeholders (pending real build photos); some part models are marked TBD.
2026-07-16 8x-5090: add Inside the machine section — real interior photos + hover video
    Five build photos (open chassis, dual-EPYC board, card install, top-down interior, rear CRPS PSUs) as web-sized webp in photos/gallery, plus a click-to-play hover video. Replaces the old build-8x.jpg.
2026-07-16 8x-5090: swap Build-it gallery to interior detail shots; finished photo to open chassis
    Build-it 2x2 now shows the dual-EPYC board, a card install, the top-down interior, and the rear CRPS PSUs. Finished-machine shot is the open-chassis view. Intro video unchanged for now.
2026-07-16 8x-5090: even 2x2 photo grid like 4x-5090 (crop two shots to 16:9)
    Match the 4x-5090 layout — a plain 2x2, 50/50 cells. Cropped card-install and psu-rear from 4:3 to 16:9 so all four photos share one aspect and the grid is even.
