bhardwajRahul/autonomous-computer/(notices)

Notices in the files:
2x-rtx5090/README.md:
License: MIT
